GoldenExperienceR/EEE4022S_TRKJON002_Solar_Car/figures/ch4_assembled_car.jpg

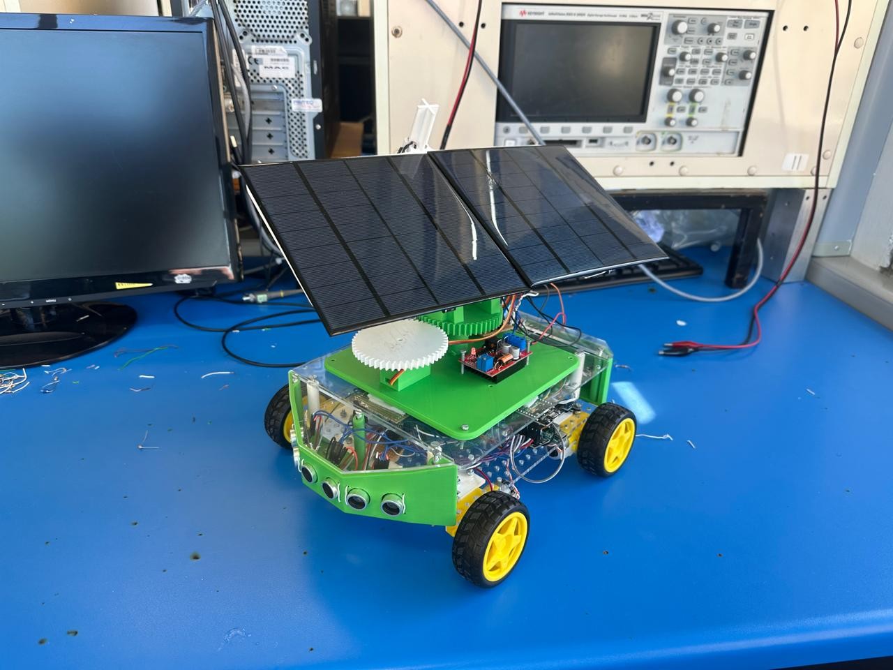
figures/ch4_assembled_car.jpg
