GoldenExperienceR/EEE4022S_TRKJON002_Solar_Car/analysis/README.md

# analysis/

Python / Jupyter post-processing of bench and track test data.

- Reduce raw captures to tidy CSV, then plot from the reduced data
- Efficiency calculations, run-time and charge-time results
- Figures exported for the report — keep the generating script alongside each figure
