GoldenExperienceR/EEE4022S_TRKJON002_Solar_Car/docs/README.md

# docs/

- Design decisions and their justification against the six project objectives
- Test procedures and results logs
- Supervisor meeting notes
- Outreach event material: pre/post interest-and-knowledge survey, media content
