GoldenExperienceR/EEE4022S_TRKJON002_Solar_Car/simulation/README.md

# simulation/

MATLAB / Simulink models and supporting scripts.

Built up submodule by submodule:
1. Solar PV under variable irradiance and temperature
2. Battery / storage
3. Motor and drivetrain
4. Power management and MPPT control
5. Full-vehicle energy model

Keep each submodule validated against literature before integrating the next.
