GoldenExperienceR/EEE4022S_TRKJON002_Solar_Car/media/out-01/out-01_questionnaire.docx

Solar Car Demonstration

Side 1: BEFORE the demonstration

University of Cape Town, Department of Electrical Engineering | Ethics approval: EBE REC EBE/03373/2026

Form ID (filled in by facilitator): ________ | Grade: ________

Section A: Consent

My parent or guardian has signed the consent form, and I agree to take part. ☐ Yes ☐ No

If you ticked No, please stop here and hand this sheet back. You can still watch and enjoy the demonstration.

Do not write your name anywhere. Your answers are anonymous, there are no right or wrong answers, and this is not a test.

For each statement, tick ONE box: 1 = Not at all 2 = A little 3 = Somewhat 4 = Quite a lot 5 = Very much

Section B: Your understanding right now

# | Statement | 1 | 2 | 3 | 4 | 5

B1 | I understand what engineers do. | ☐ | ☐ | ☐ | ☐ | ☐
B2 | I understand how electrical engineering is used in everyday devices. | ☐ | ☐ | ☐ | ☐ | ☐
B3 | I understand how solar (renewable) energy can be used to power something, like a small vehicle. | ☐ | ☐ | ☐ | ☐ | ☐
B4 | I understand how different types of engineering (e.g. mechanical, electrical, renewable energy, coding) work together on a single project. | ☐ | ☐ | ☐ | ☐ | ☐

Section C: Your interest right now

# | Statement | 1 | 2 | 3 | 4 | 5

C1 | I am interested in learning more about engineering. | ☐ | ☐ | ☐ | ☐ | ☐
C2 | I would consider studying engineering in the future. | ☐ | ☐ | ☐ | ☐ | ☐
C3 | I am interested in careers related to science, technology, engineering or maths (STEM). | ☐ | ☐ | ☐ | ☐ | ☐
C4 | I am interested in working in renewable energy one day. | ☐ | ☐ | ☐ | ☐ | ☐

Do not turn over yet. Keep this sheet; you will fill in Side 2 after the demonstration.

Solar Car Demonstration

Side 2: AFTER the demonstration

Only fill in this side when the facilitator asks you to, after the demonstration. Same sheet and same Form ID as Side 1.

For each statement, tick ONE box: 1 = Not at all 2 = A little 3 = Somewhat 4 = Quite a lot 5 = Very much

Section B: Your understanding now, after the demonstration

# | Statement | 1 | 2 | 3 | 4 | 5

B1 | I understand what engineers do. | ☐ | ☐ | ☐ | ☐ | ☐
B2 | I understand how electrical engineering is used in everyday devices. | ☐ | ☐ | ☐ | ☐ | ☐
B3 | I understand how solar (renewable) energy can be used to power something, like a small vehicle. | ☐ | ☐ | ☐ | ☐ | ☐
B4 | I understand how different types of engineering (e.g. mechanical, electrical, renewable energy, coding) work together on a single project. | ☐ | ☐ | ☐ | ☐ | ☐

Section C: Your interest now, after the demonstration

# | Statement | 1 | 2 | 3 | 4 | 5

C1 | I am interested in learning more about engineering. | ☐ | ☐ | ☐ | ☐ | ☐
C2 | I would consider studying engineering in the future. | ☐ | ☐ | ☐ | ☐ | ☐
C3 | I am interested in careers related to science, technology, engineering or maths (STEM). | ☐ | ☐ | ☐ | ☐ | ☐
C4 | I am interested in working in renewable energy one day. | ☐ | ☐ | ☐ | ☐ | ☐

Section D: Your impression of today's demonstration

# | Statement | 1 | 2 | 3 | 4 | 5

D1 | I enjoyed today's demonstration. | ☐ | ☐ | ☐ | ☐ | ☐
D2 | The demonstration was easy to understand. | ☐ | ☐ | ☐ | ☐ | ☐
D3 | Today's demonstration made me more curious about engineering. | ☐ | ☐ | ☐ | ☐ | ☐
D4 | Did you drive the car yourself? If No, skip D5 to D7. | ☐ Yes ☐ No
D5 | The phone dashboard was easy to use. | ☐ | ☐ | ☐ | ☐ | ☐
D6 | I liked the look of the dashboard. | ☐ | ☐ | ☐ | ☐ | ☐
D7 | Driving was easier with co-pilot on than with it off. | ☐ | ☐ | ☐ | ☐ | ☐
D8 | Seeing live data (solar power, battery, speed) helped me understand how the car works. | ☐ | ☐ | ☐ | ☐ | ☐
D9 | Being able to drive the car made the demonstration more interesting. | ☐ | ☐ | ☐ | ☐ | ☐

Thank you! Please hand this sheet back to the facilitator.
