GoldenExperienceR/EEE4022S_TRKJON002_Solar_Car/figures/app_consent_form-2.png

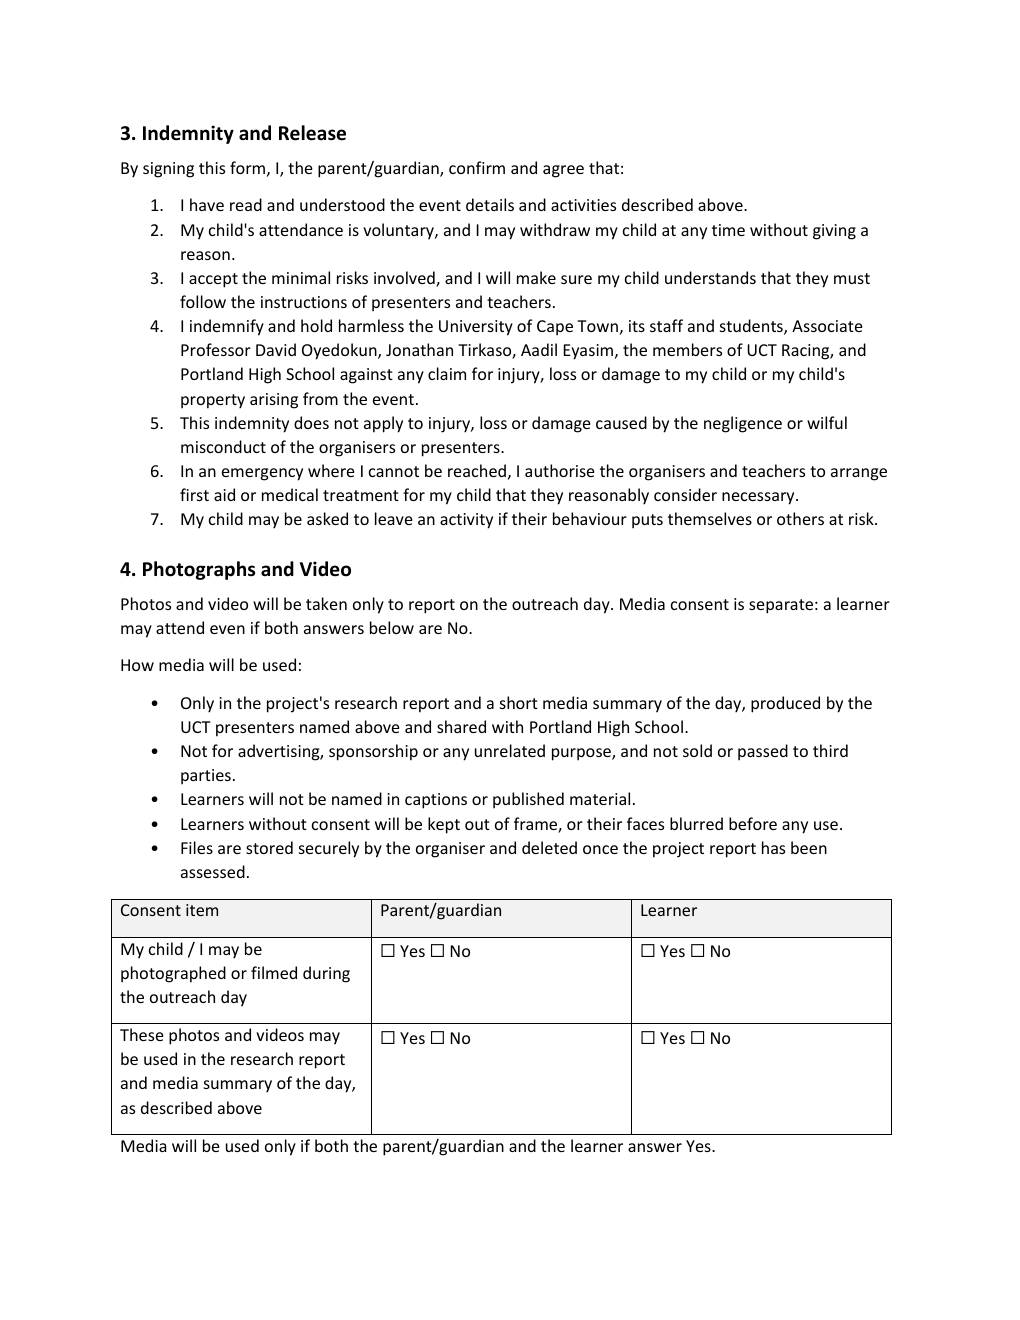
figures/app_consent_form-2.png
