GoldenExperienceR/EEE4022S_TRKJON002_Solar_Car/figures/app_ethics_approval-1.png

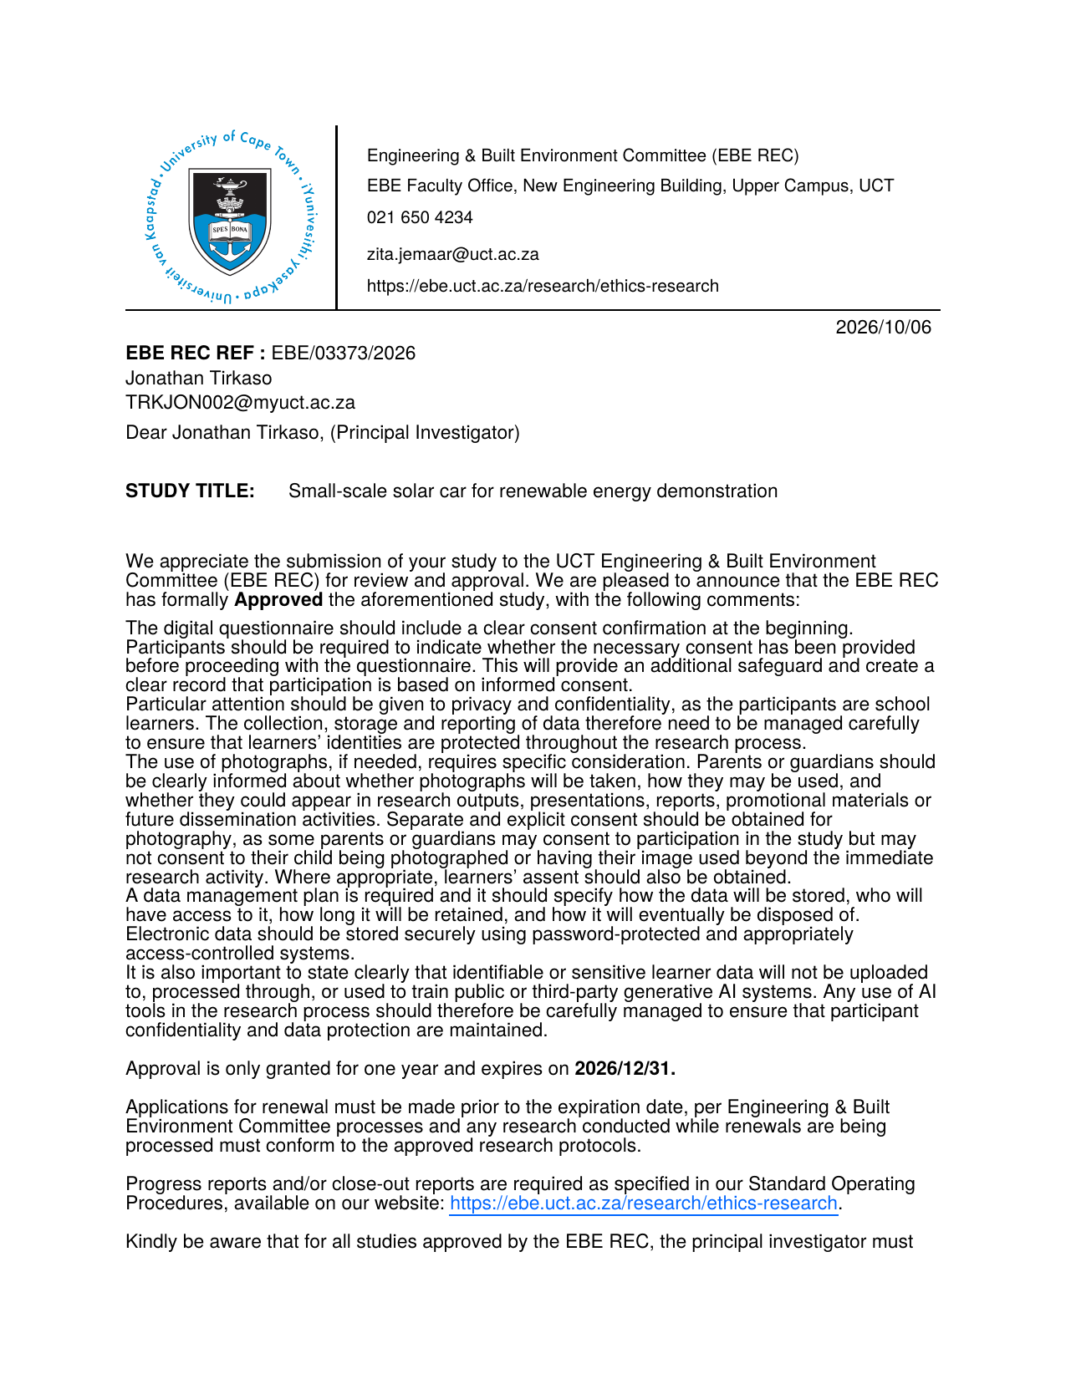
figures/app_ethics_approval-1.png
