GoldenExperienceR/EEE4022S_TRKJON002_Solar_Car/figures/app_photo_front.jpg

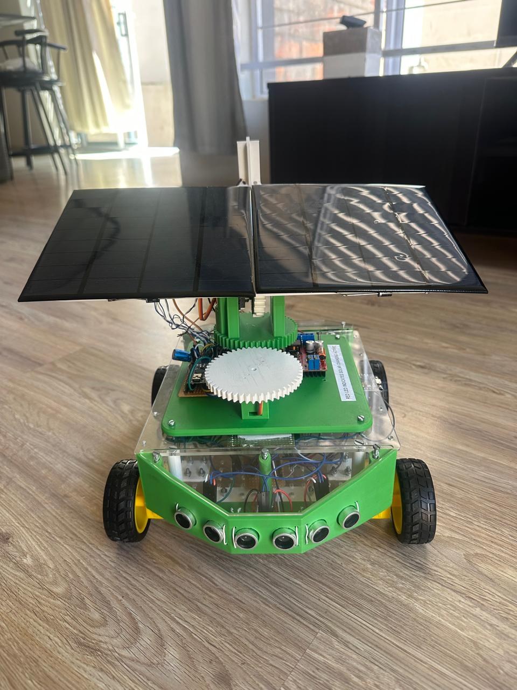
figures/app_photo_front.jpg
