GoldenExperienceR/EEE4022S_TRKJON002_Solar_Car/figures/app_photo_rear.jpg

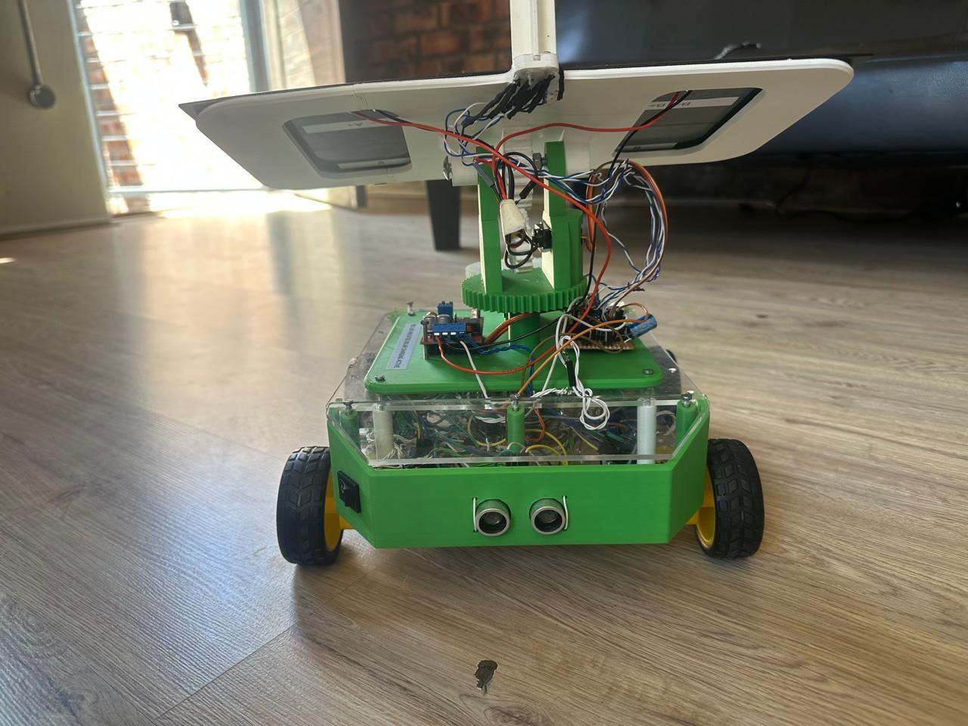
figures/app_photo_rear.jpg
