GoldenExperienceR/EEE4022S_TRKJON002_Solar_Car/figures/app_vehicle_front.jpg

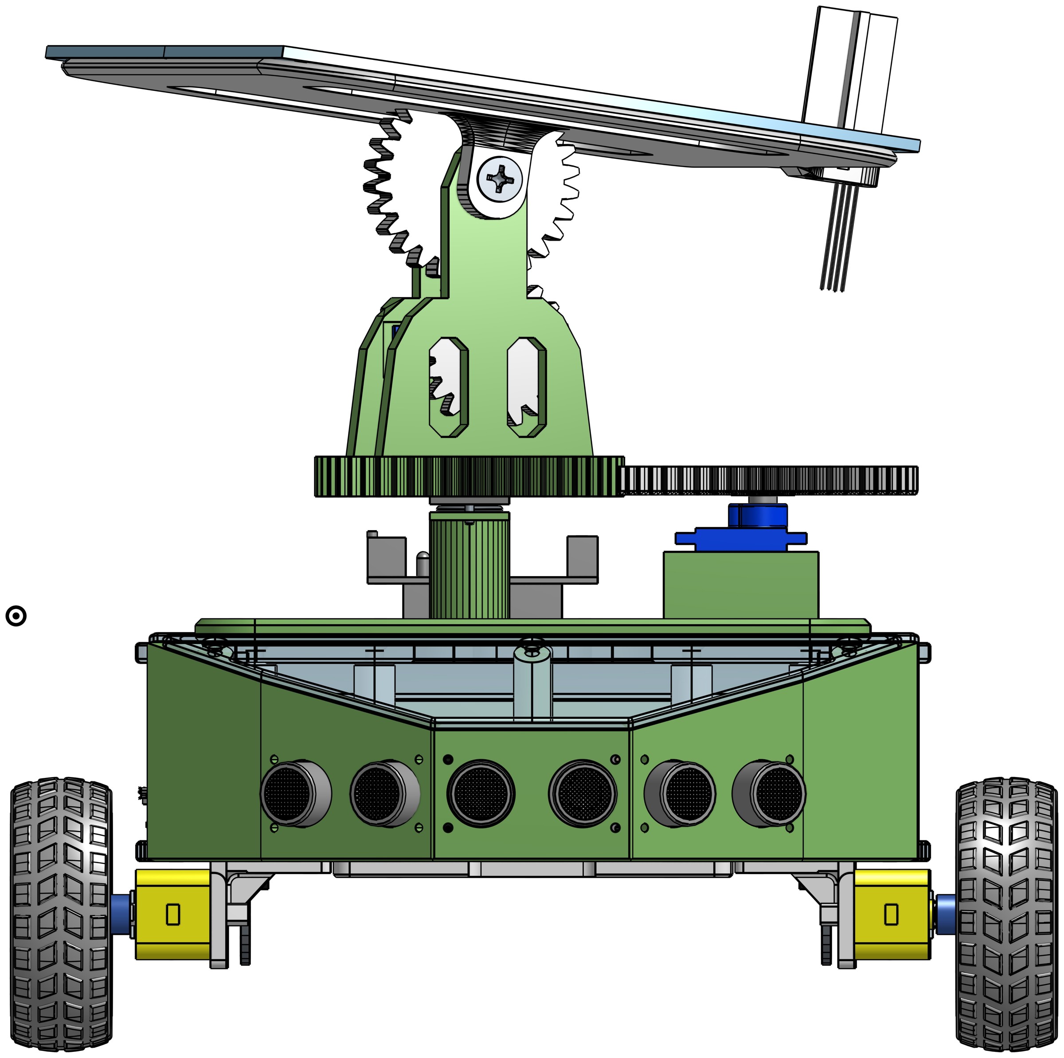
figures/app_vehicle_front.jpg
