GoldenExperienceR/EEE4022S_TRKJON002_Solar_Car/figures/app_vehicle_rear.jpg

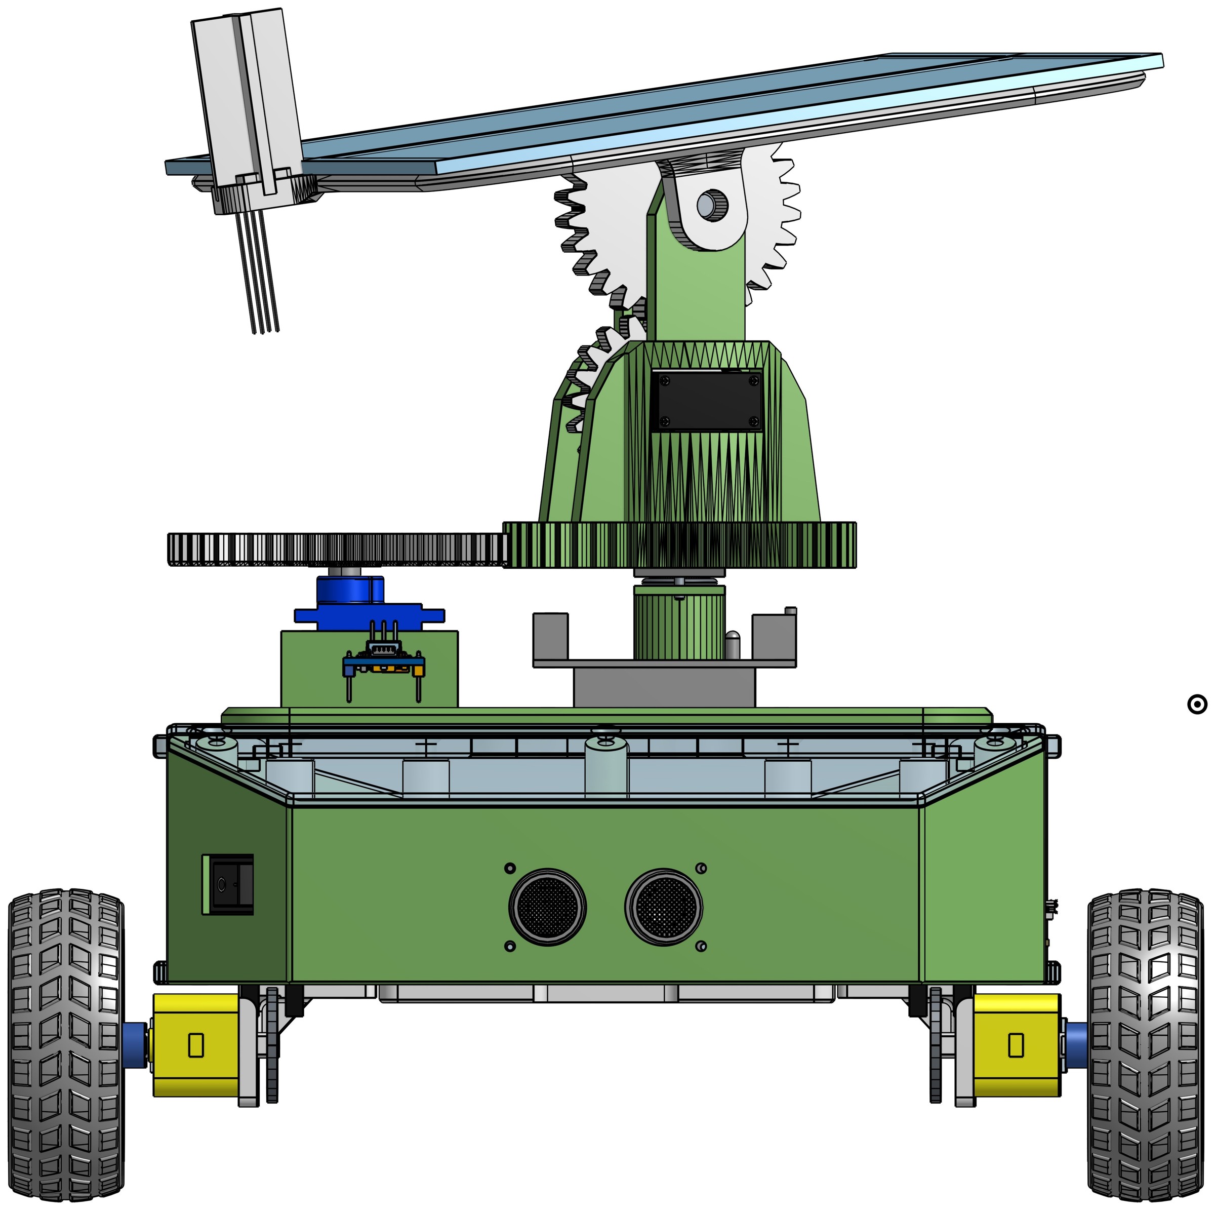
figures/app_vehicle_rear.jpg
