GoldenExperienceR/EEE4022S_TRKJON002_Solar_Car/figures/ch2_array_config_bottom.png

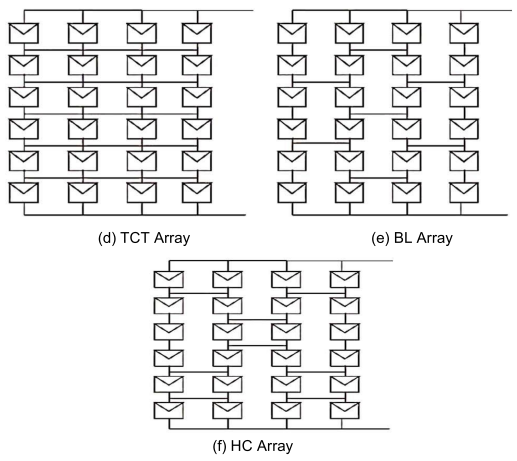
figures/ch2_array_config_bottom.png
