GoldenExperienceR/EEE4022S_TRKJON002_Solar_Car/figures/ch2_array_config_top.png

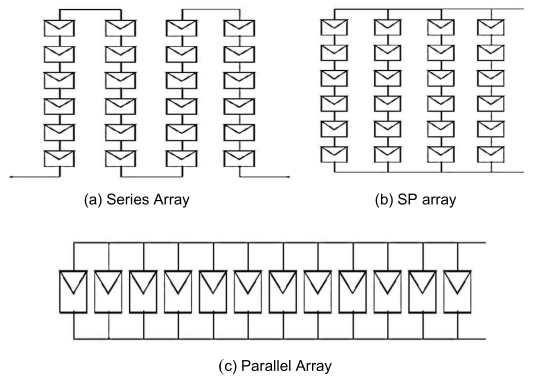
figures/ch2_array_config_top.png
