GoldenExperienceR/EEE4022S_TRKJON002_Solar_Car/figures/ch2_effect_irradiance.png

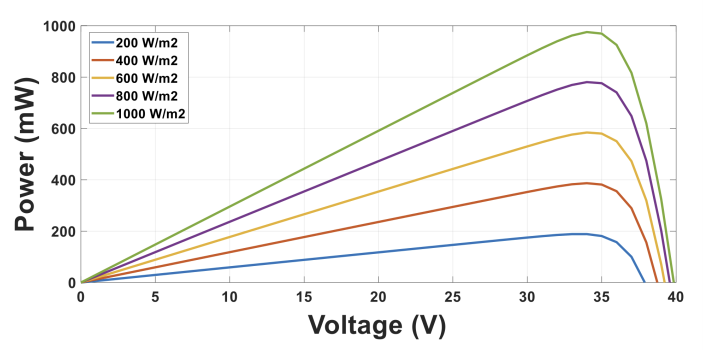
figures/ch2_effect_irradiance.png
