GoldenExperienceR/EEE4022S_TRKJON002_Solar_Car/figures/ch2_effect_series_r.png

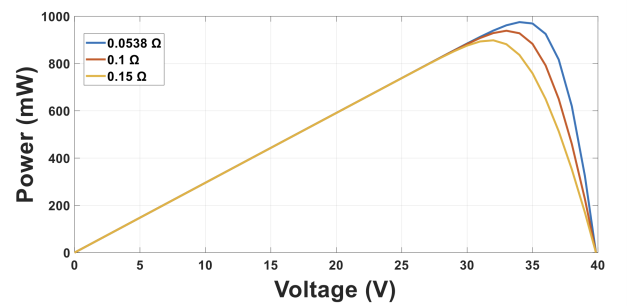
figures/ch2_effect_series_r.png
