GoldenExperienceR/EEE4022S_TRKJON002_Solar_Car/figures/ch2_effect_temperature.png

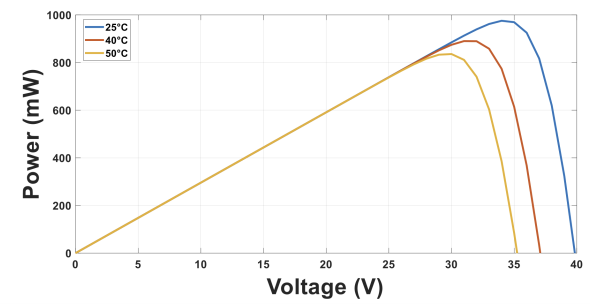
figures/ch2_effect_temperature.png
