GoldenExperienceR/EEE4022S_TRKJON002_Solar_Car/figures/ch2_howell2023_tail.png

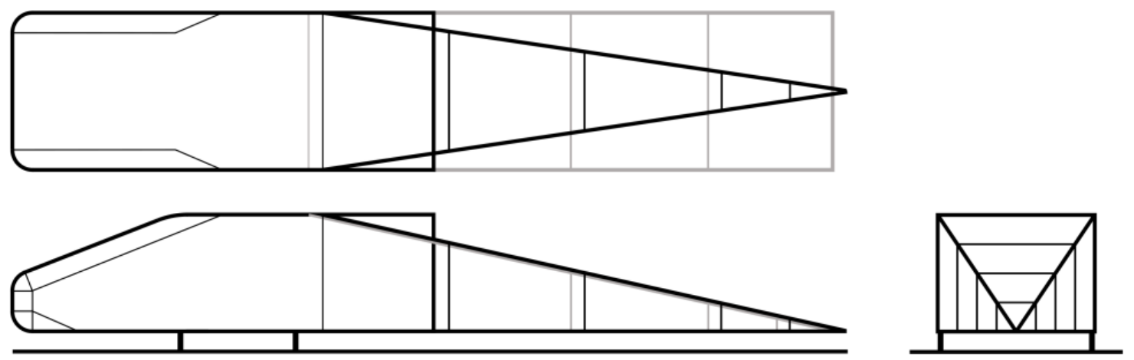
figures/ch2_howell2023_tail.png
