GoldenExperienceR/EEE4022S_TRKJON002_Solar_Car/figures/ch2_iv_pv_curves.png

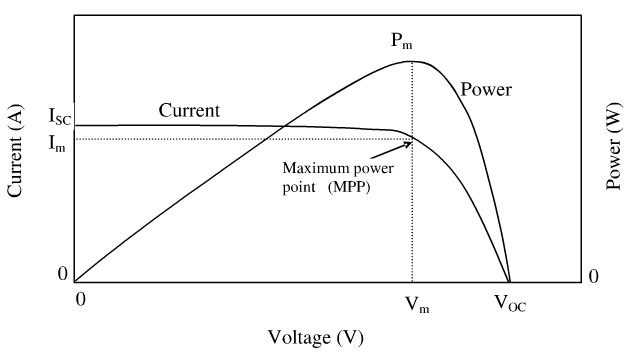
figures/ch2_iv_pv_curves.png
