GoldenExperienceR/EEE4022S_TRKJON002_Solar_Car/figures/ch2_microev_control.png

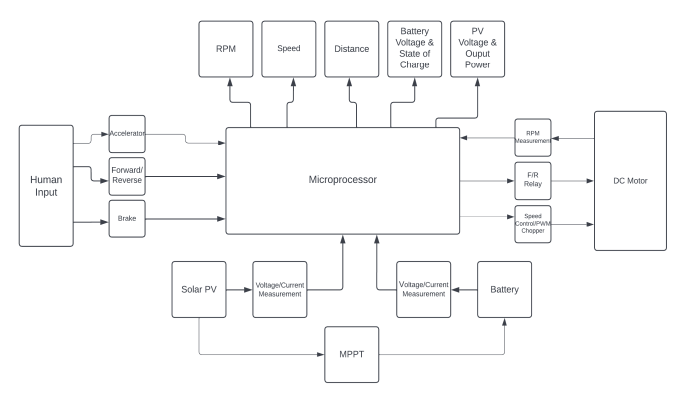
figures/ch2_microev_control.png
