GoldenExperienceR/EEE4022S_TRKJON002_Solar_Car/figures/ch2_microev_power_stage.png

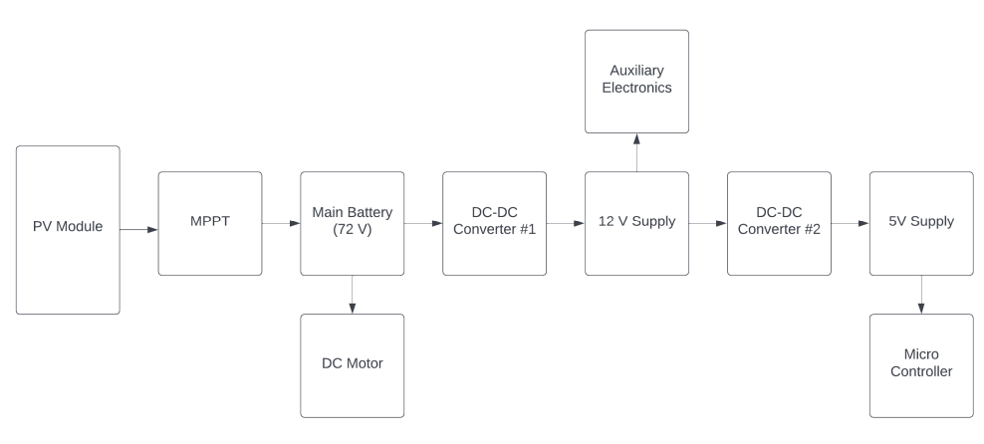
figures/ch2_microev_power_stage.png
