GoldenExperienceR/EEE4022S_TRKJON002_Solar_Car/figures/ch2_mppt_simulink.png

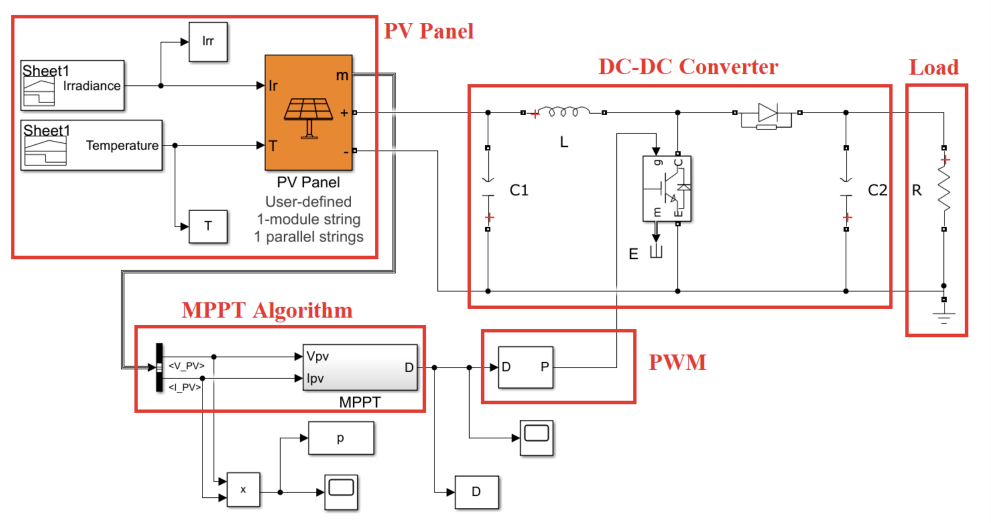
figures/ch2_mppt_simulink.png
