GoldenExperienceR/EEE4022S_TRKJON002_Solar_Car/figures/ch2_ocv_soc_lfp.png

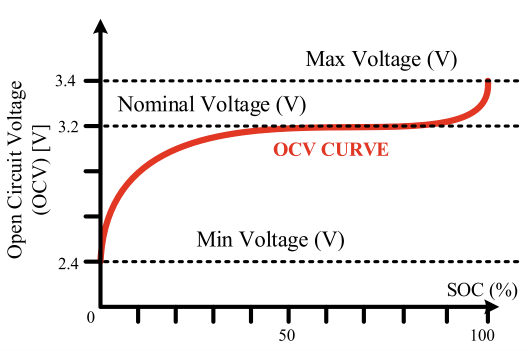
figures/ch2_ocv_soc_lfp.png
