GoldenExperienceR/EEE4022S_TRKJON002_Solar_Car/figures/ch2_pv_cell_junction.png

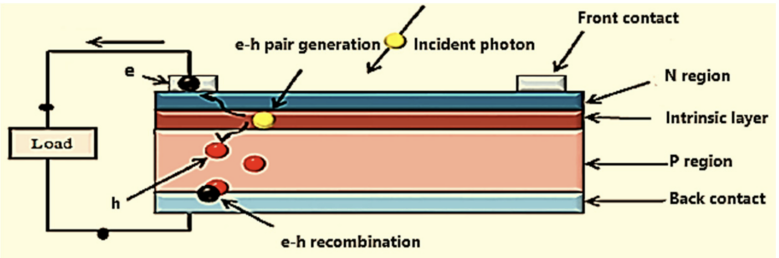
figures/ch2_pv_cell_junction.png
