GoldenExperienceR/EEE4022S_TRKJON002_Solar_Car/figures/ch2_schito2024_nose.png

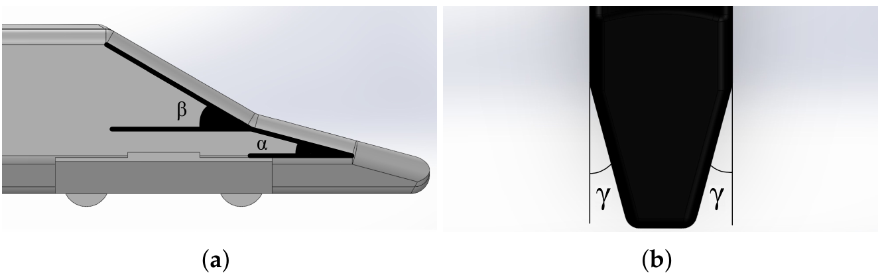
figures/ch2_schito2024_nose.png
