GoldenExperienceR/EEE4022S_TRKJON002_Solar_Car/figures/ch2_shading_distortion.png

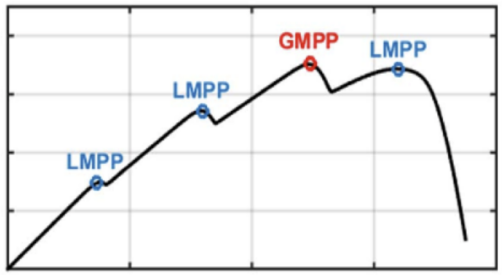
figures/ch2_shading_distortion.png
