GoldenExperienceR/EEE4022S_TRKJON002_Solar_Car/figures/ch2_single_diode_model.png

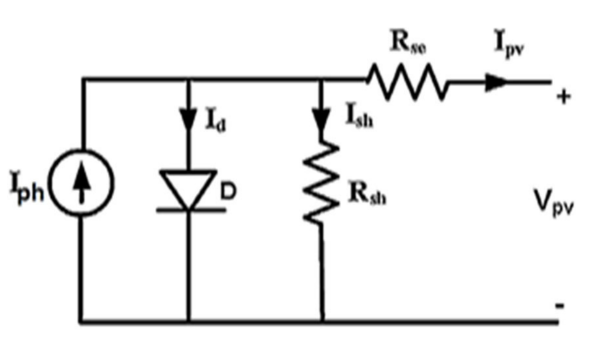
figures/ch2_single_diode_model.png
