GoldenExperienceR/EEE4022S_TRKJON002_Solar_Car/figures/ch2_v3_block_diagram.png

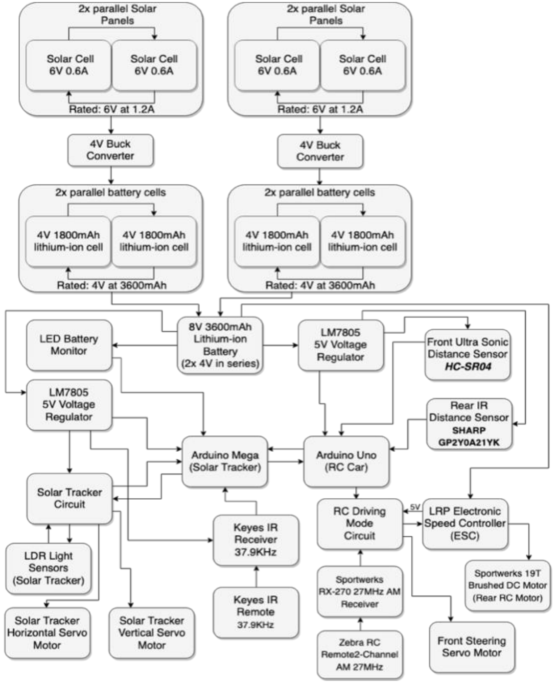
figures/ch2_v3_block_diagram.png
