GoldenExperienceR/EEE4022S_TRKJON002_Solar_Car/figures/ch2_v3_tracker_isometric.png

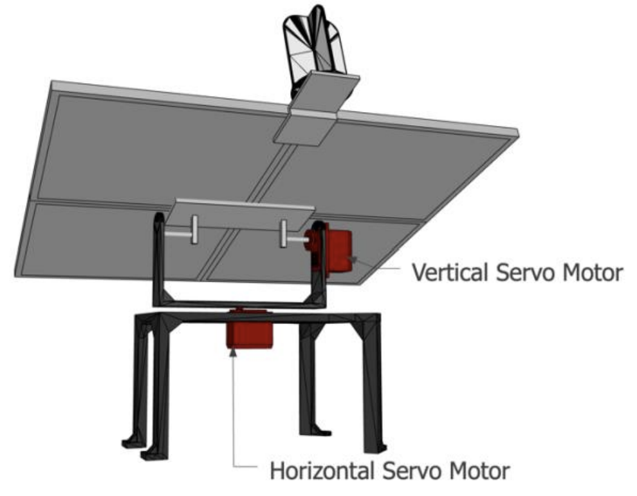
figures/ch2_v3_tracker_isometric.png
