GoldenExperienceR/EEE4022S_TRKJON002_Solar_Car/figures/ch3_copilot_controller.png

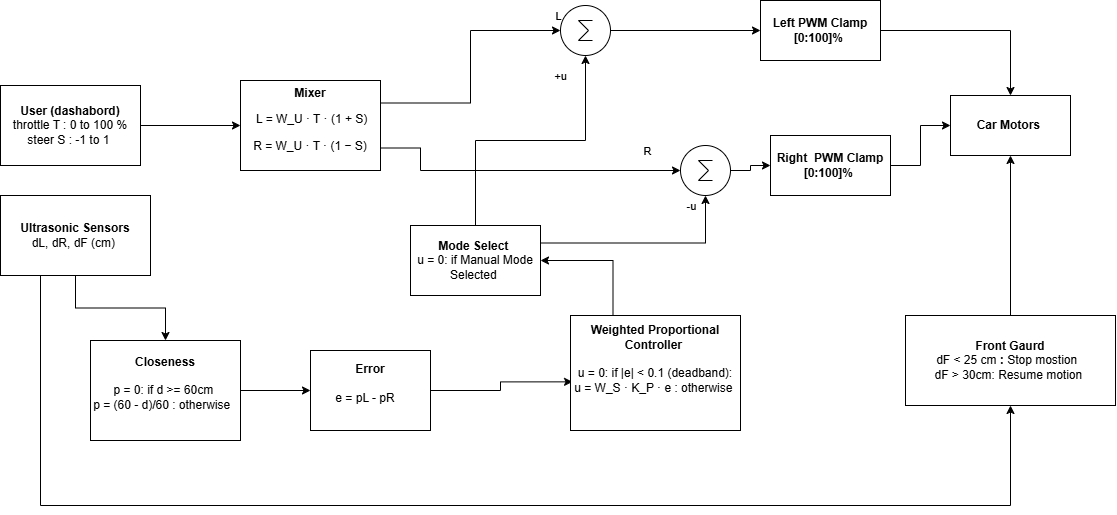
figures/ch3_copilot_controller.png
