GoldenExperienceR/EEE4022S_TRKJON002_Solar_Car/figures/ch3_sim_battery_load.png

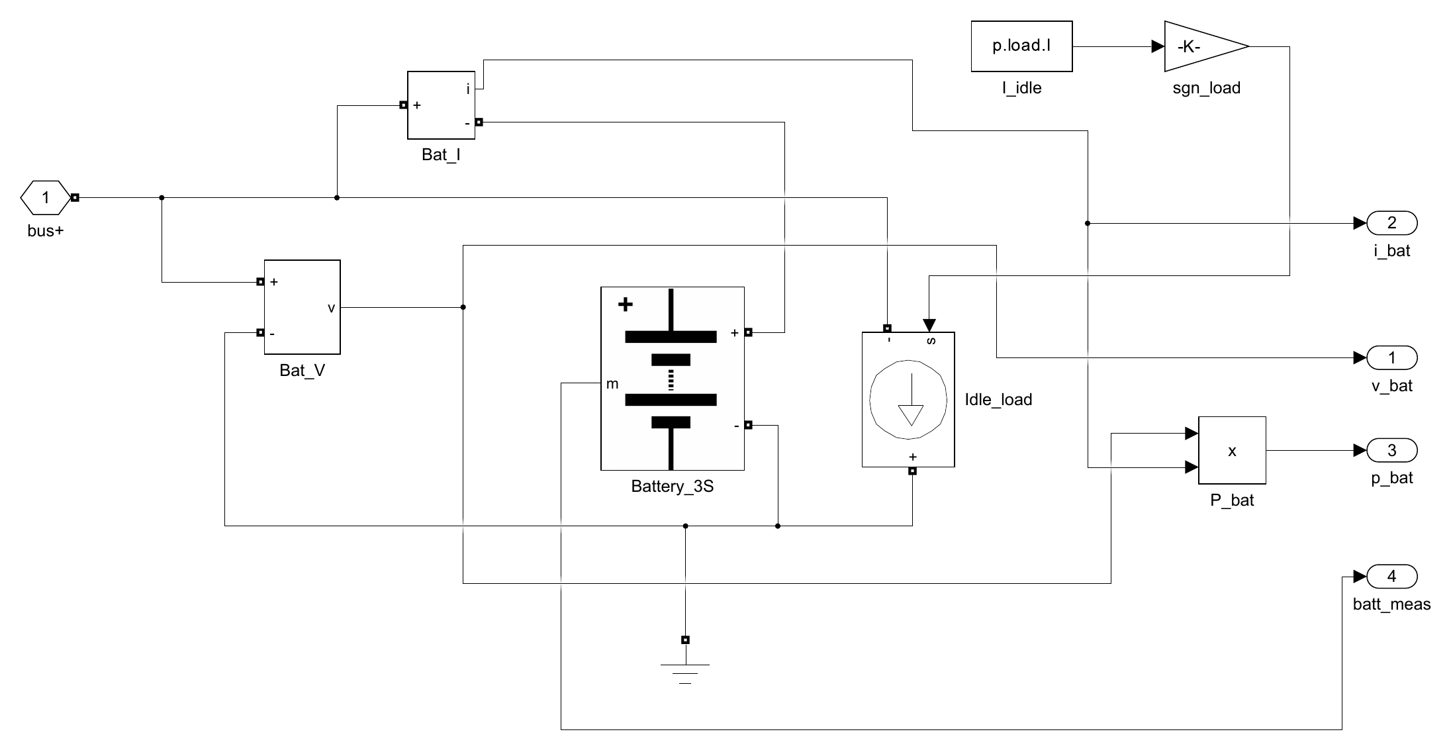
figures/ch3_sim_battery_load.png
