GoldenExperienceR/EEE4022S_TRKJON002_Solar_Car/figures/ch3_sim_converter.png

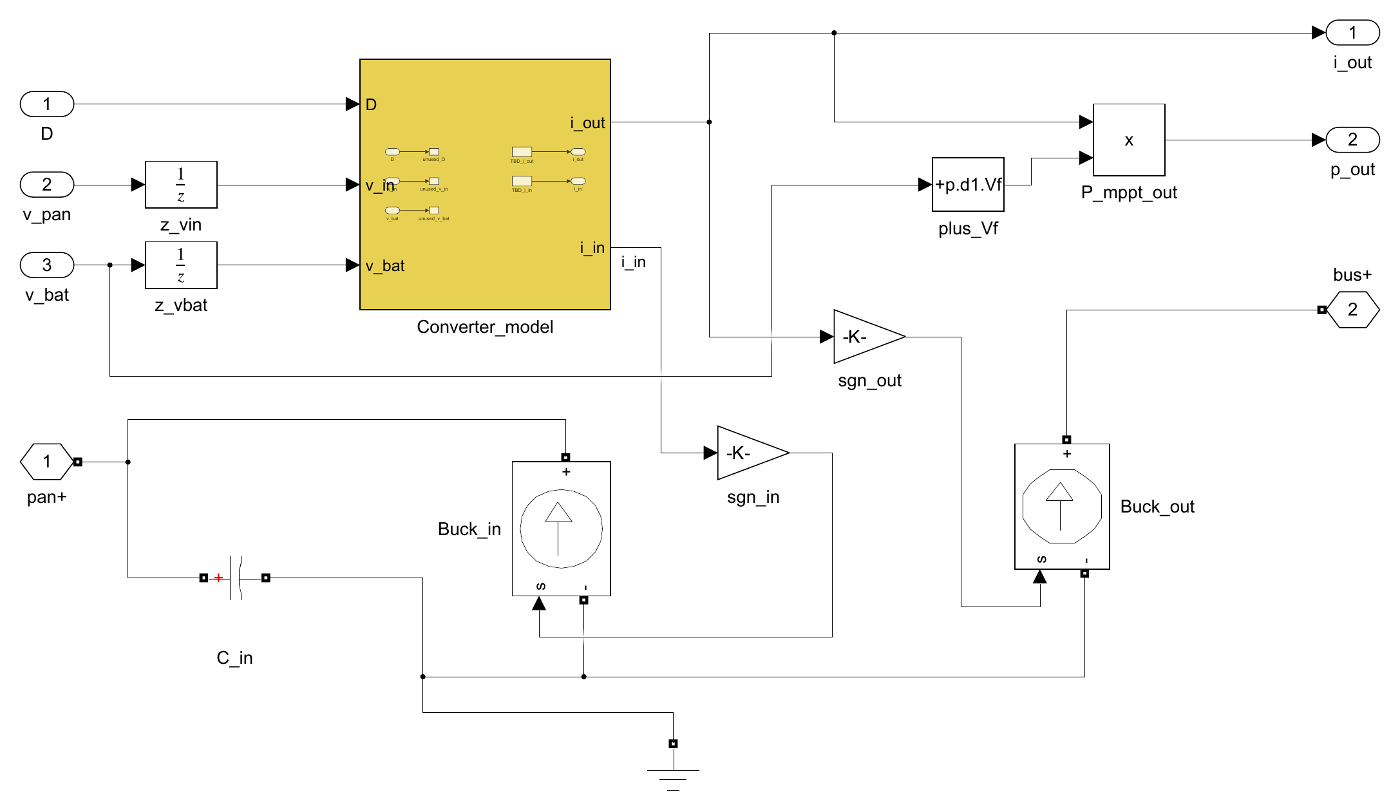
figures/ch3_sim_converter.png
