GoldenExperienceR/EEE4022S_TRKJON002_Solar_Car/figures/ch3_sim_logging.png

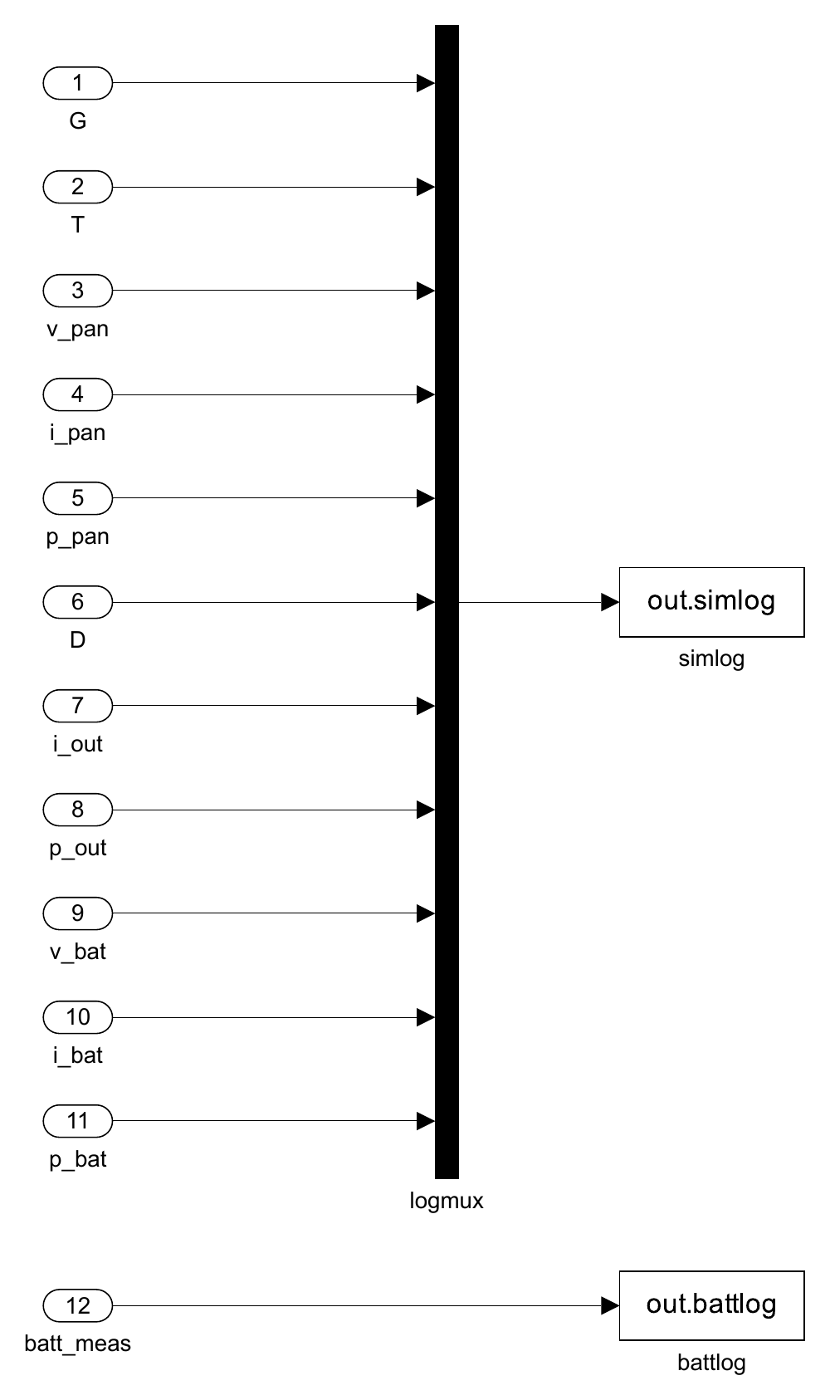
figures/ch3_sim_logging.png
