GoldenExperienceR/EEE4022S_TRKJON002_Solar_Car/figures/ch3_sim_pv_array.png

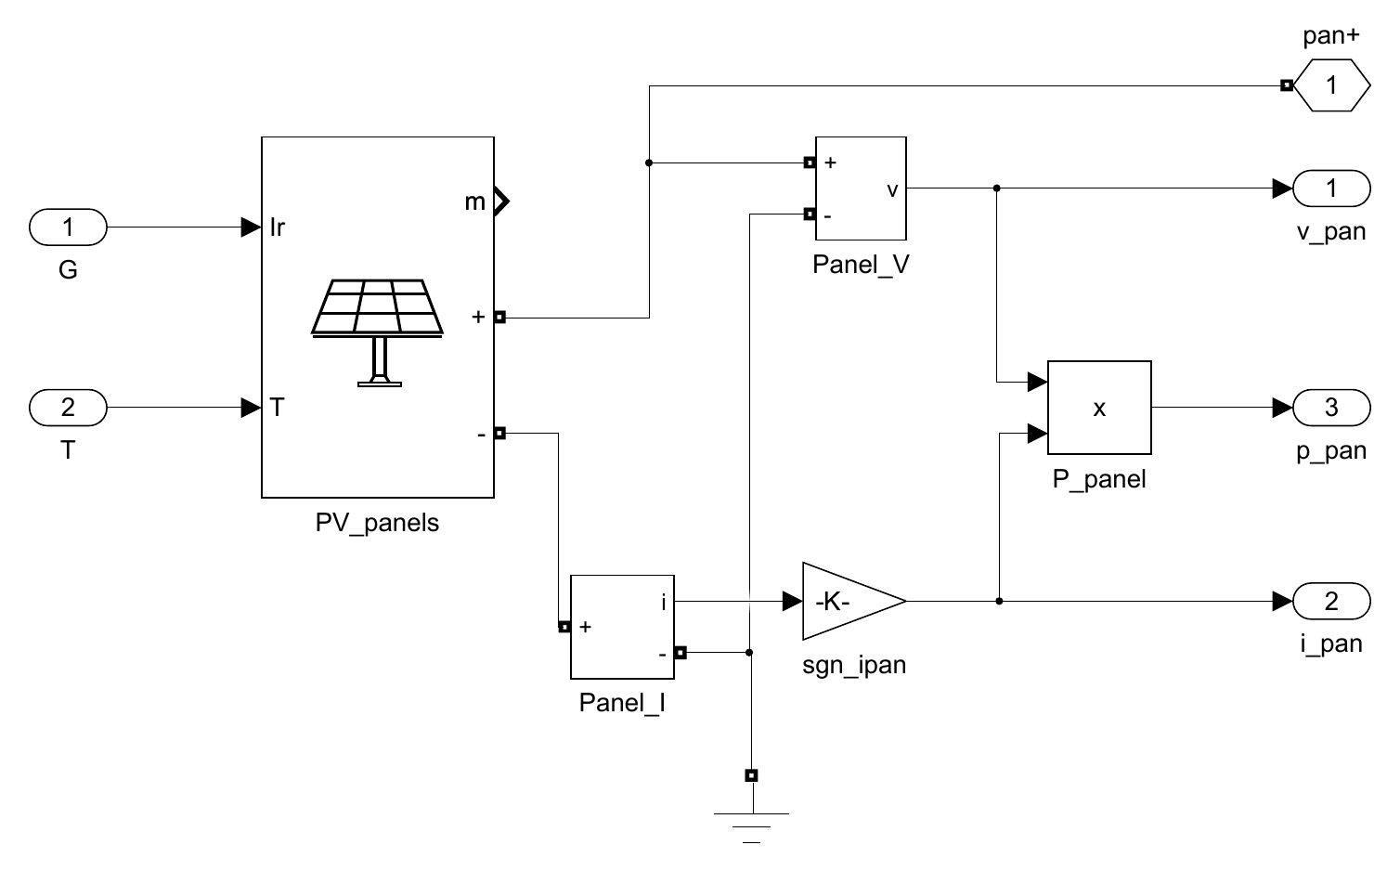
figures/ch3_sim_pv_array.png
