GoldenExperienceR/EEE4022S_TRKJON002_Solar_Car/figures/ch3_system_architecture.png

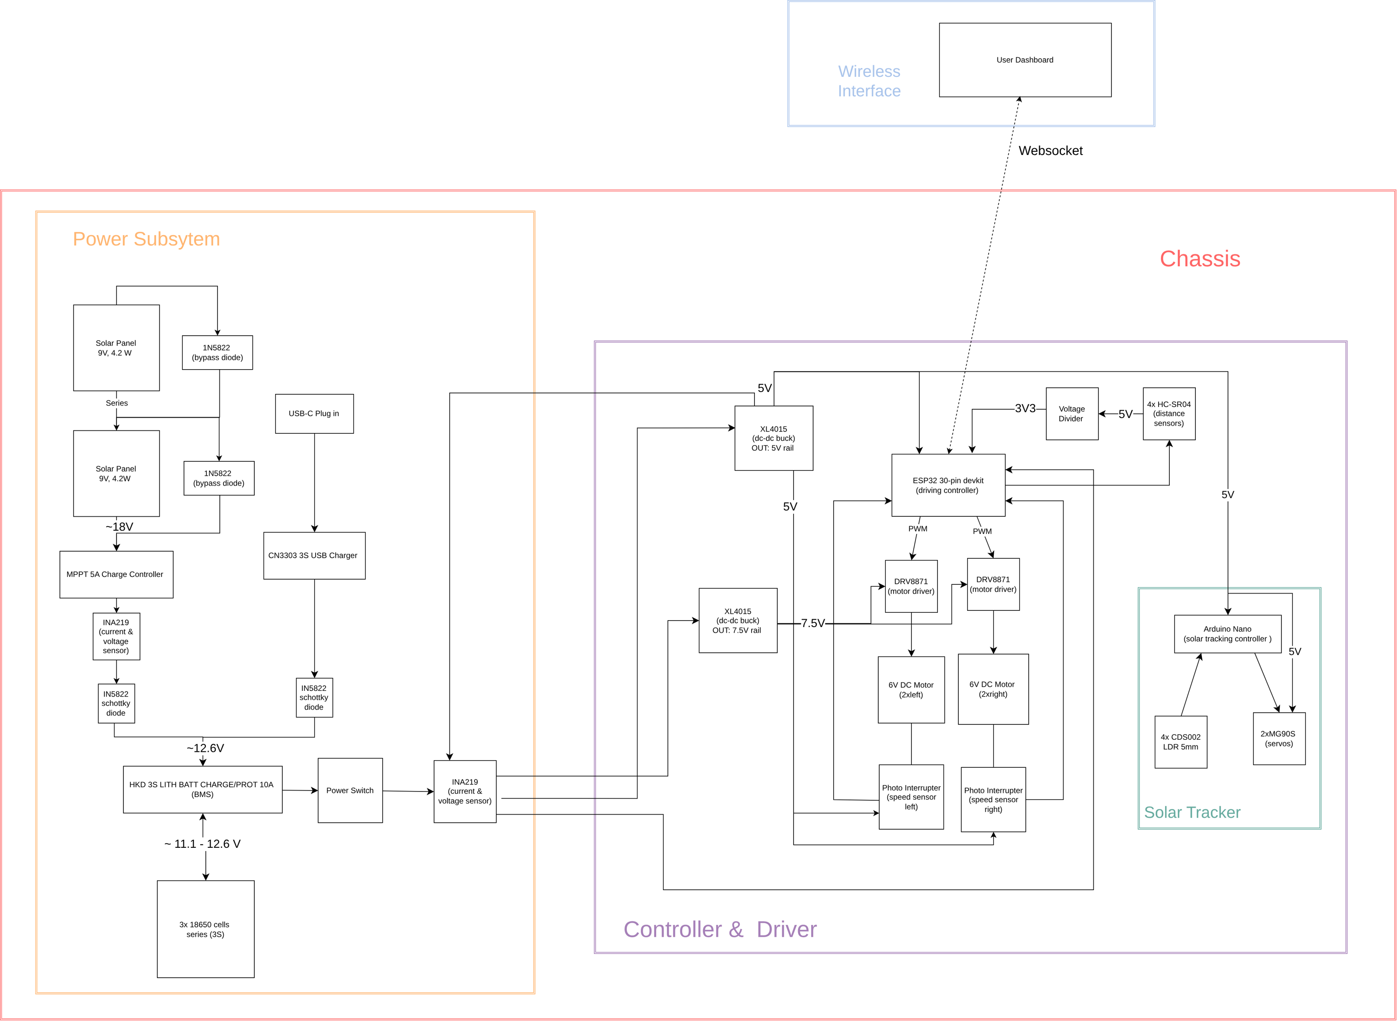
figures/ch3_system_architecture.png
