GoldenExperienceR/EEE4022S_TRKJON002_Solar_Car/figures/int02_drive_distance.jpg

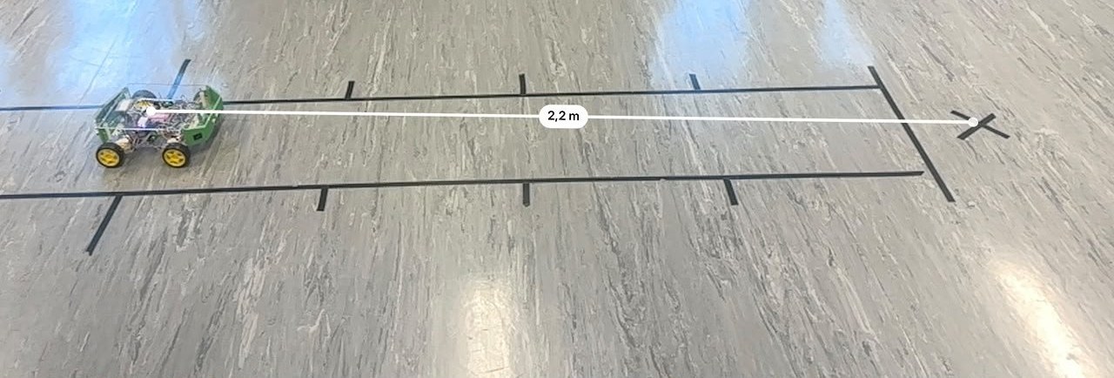
figures/int02_drive_distance.jpg
