GoldenExperienceR/EEE4022S_TRKJON002_Solar_Car/figures/out01_impressions_all.png

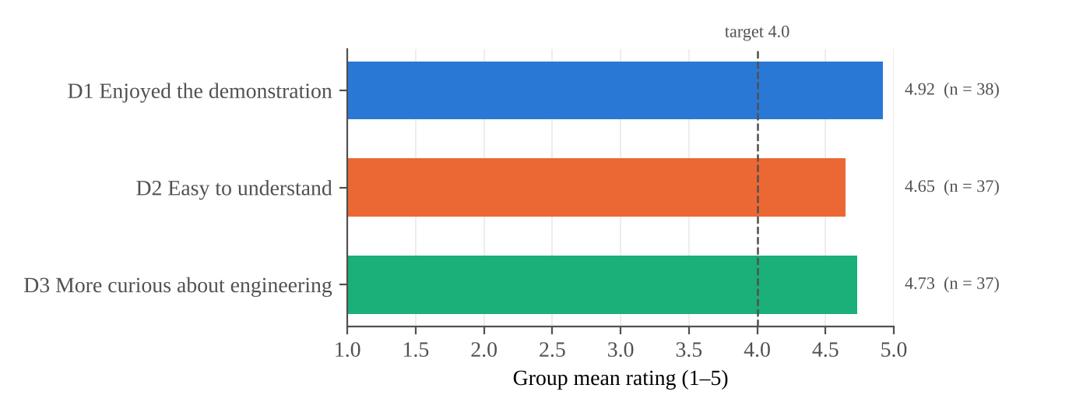
figures/out01_impressions_all.png
