GoldenExperienceR/EEE4022S_TRKJON002_Solar_Car/figures/out01_pre_post_means.png

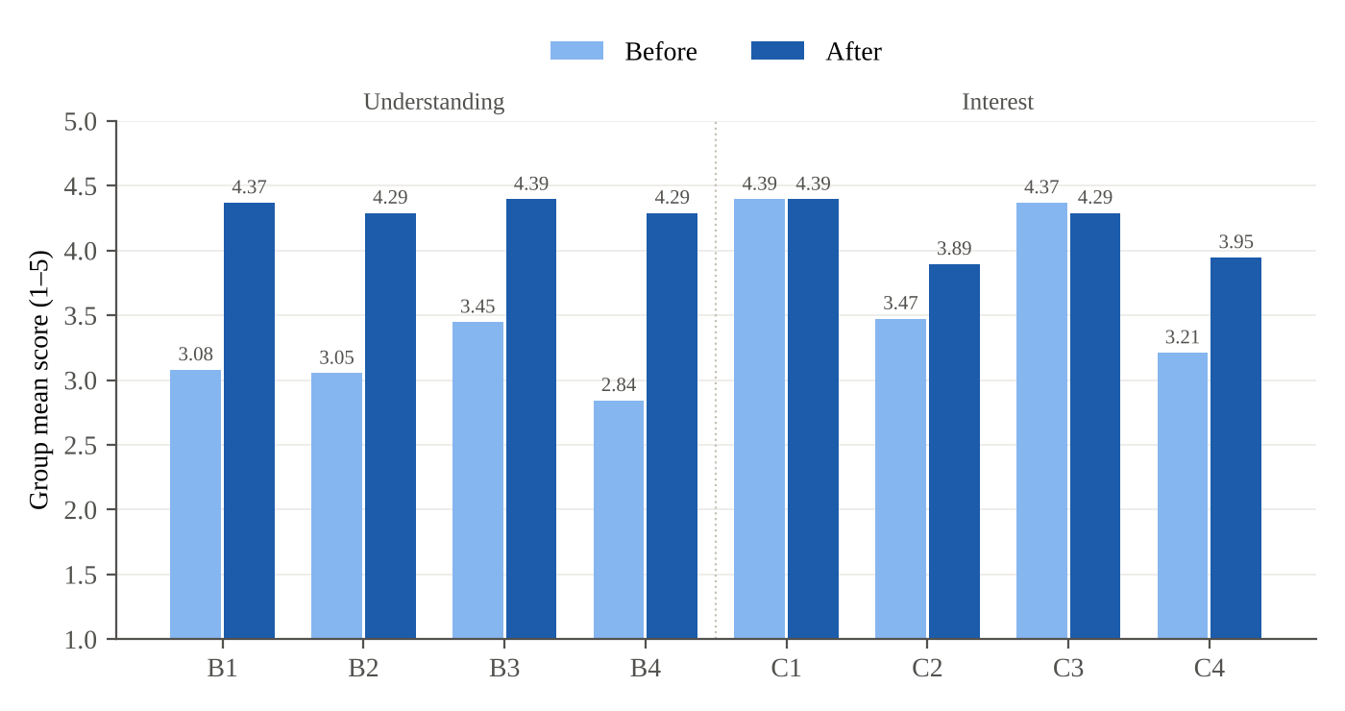
figures/out01_pre_post_means.png
