GoldenExperienceR/EEE4022S_TRKJON002_Solar_Car/figures/sim01_charging.png

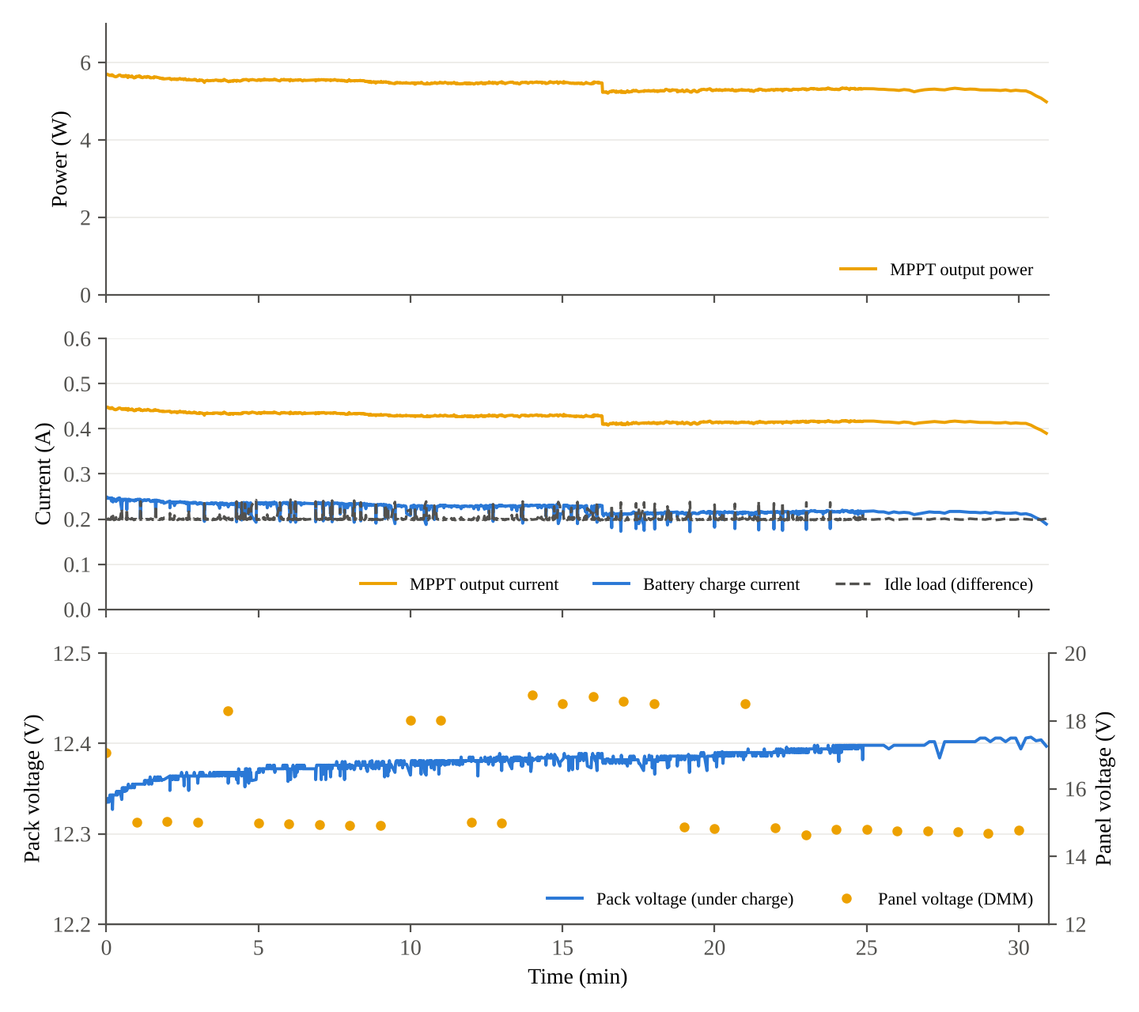
figures/sim01_charging.png
