GoldenExperienceR/EEE4022S_TRKJON002_Solar_Car/figures/sim01_conditions.png

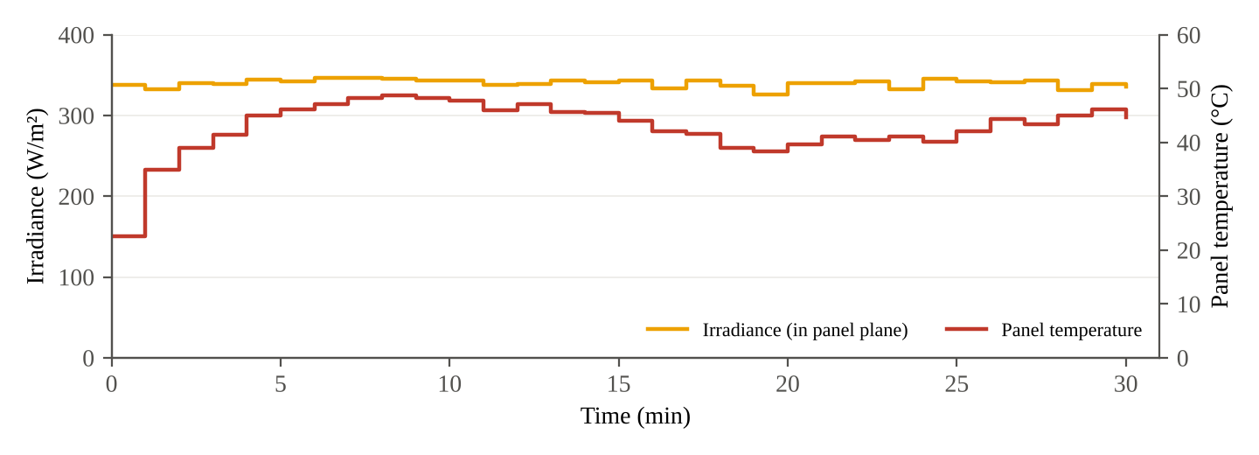
figures/sim01_conditions.png
