GoldenExperienceR/EEE4022S_TRKJON002_Solar_Car/figures/sys10_mass.jpg

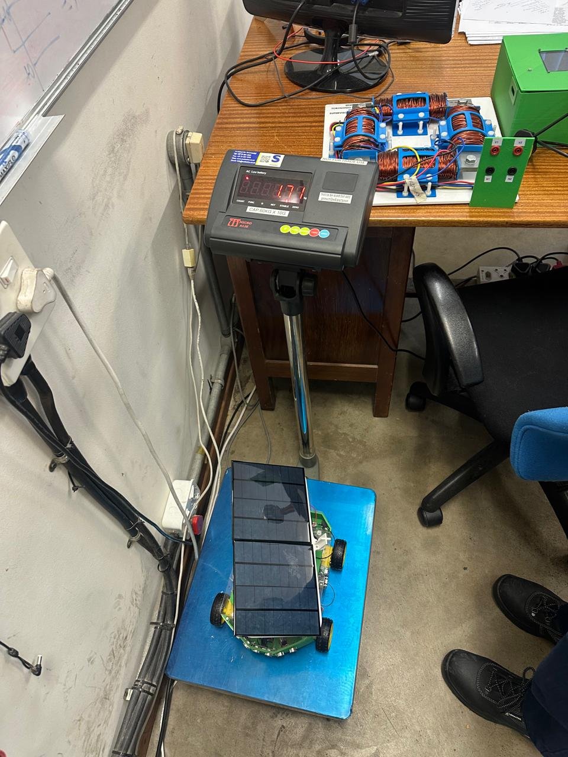
figures/sys10_mass.jpg
