GoldenExperienceR/EEE4022S_TRKJON002_Solar_Car/figures/sys14_shade1.png

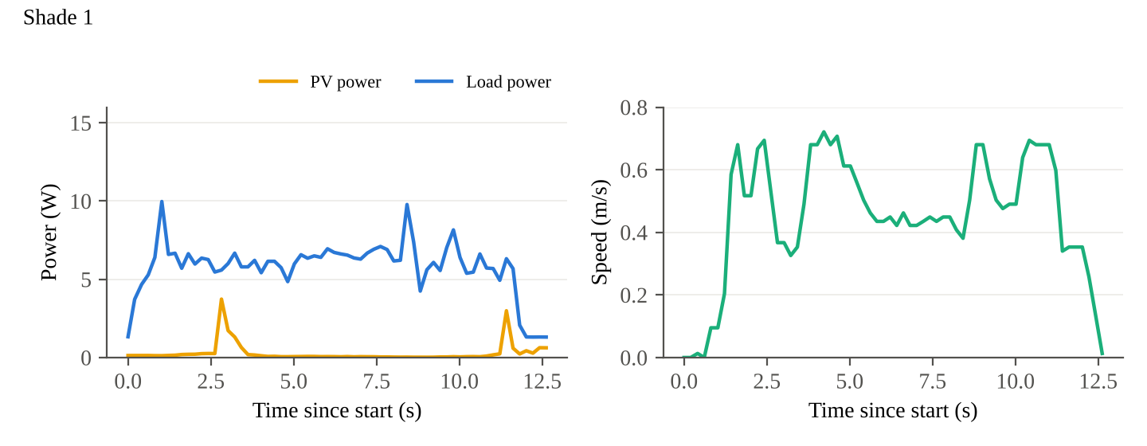
figures/sys14_shade1.png
