GoldenExperienceR/EEE4022S_TRKJON002_Solar_Car/figures/sys14_sun1.png

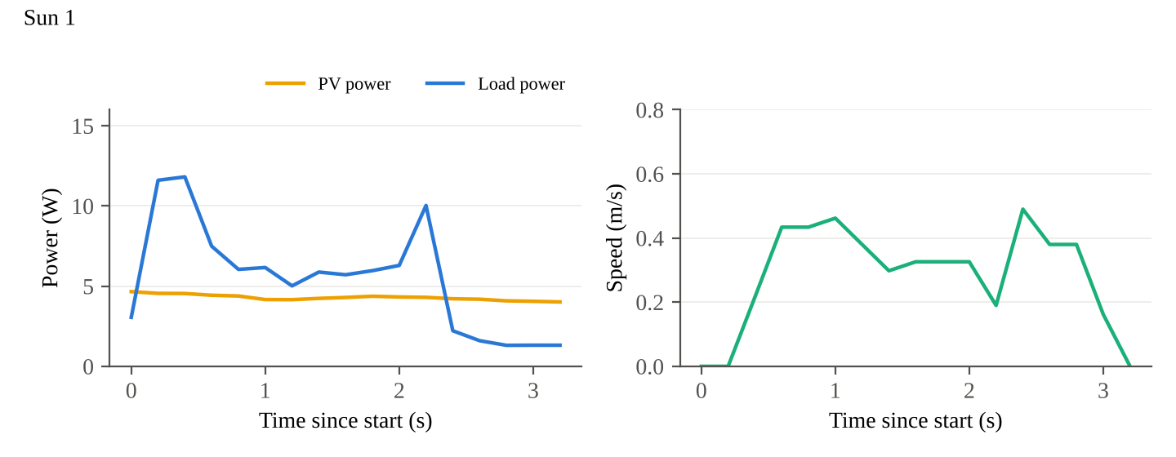
figures/sys14_sun1.png
