GoldenExperienceR/EEE4022S_TRKJON002_Solar_Car/figures/u04_ripple_buck_a.png

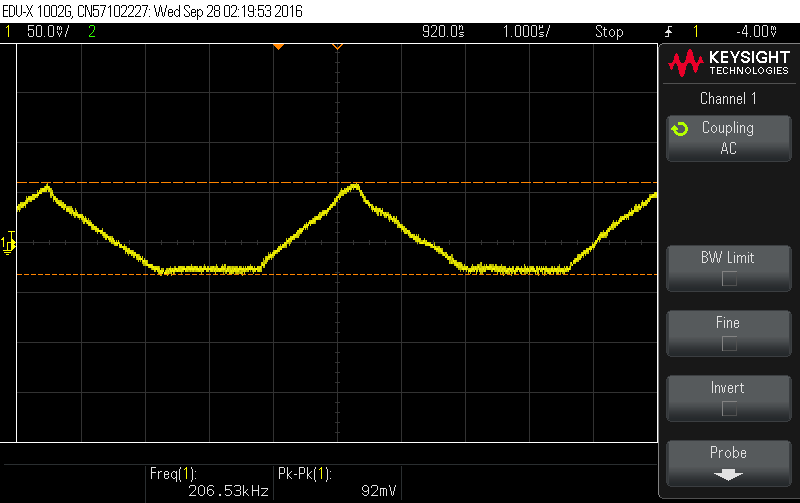
figures/u04_ripple_buck_a.png
