GoldenExperienceR/EEE4022S_TRKJON002_Solar_Car/figures/u07_mppt_charge_ripple.png

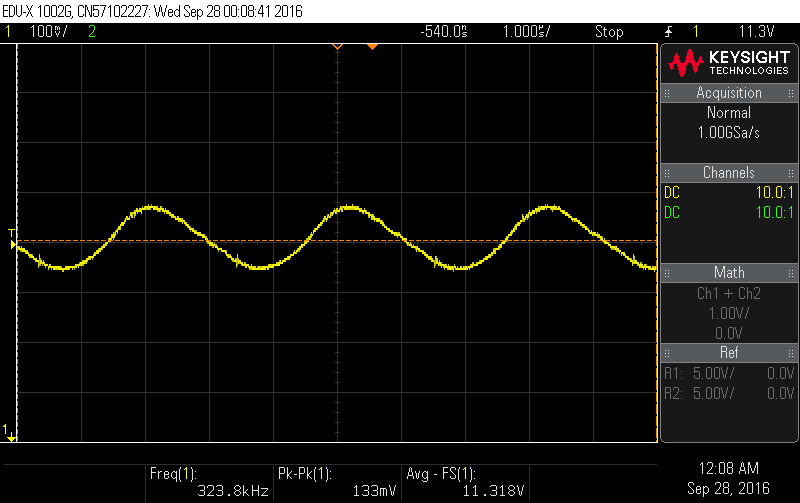
figures/u07_mppt_charge_ripple.png
