GoldenExperienceR/EEE4022S_TRKJON002_Solar_Car/figures/u07_mppt_output_bench.png

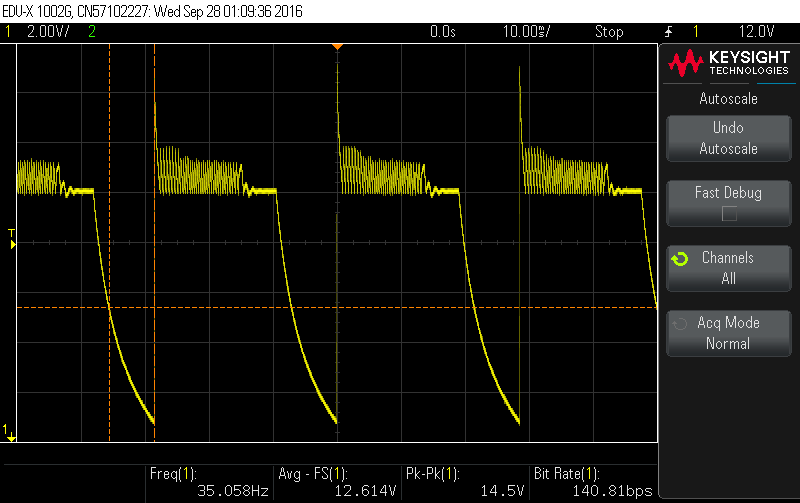
figures/u07_mppt_output_bench.png
