GoldenExperienceR/EEE4022S_TRKJON002_Solar_Car/media/sys-06/sys-06_dashboard_before-usb.png

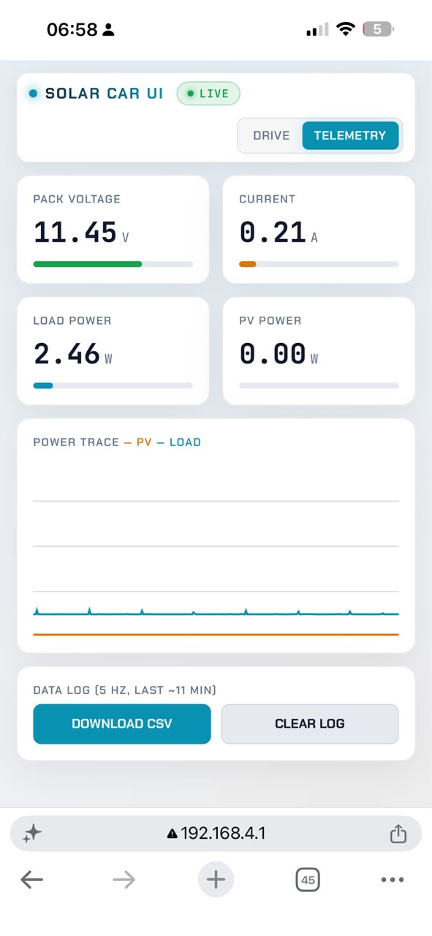
media/sys-06/sys-06_dashboard_before-usb.png
