GoldenExperienceR/EEE4022S_TRKJON002_Solar_Car/modelling and schematics/online components/enkoder30.stl

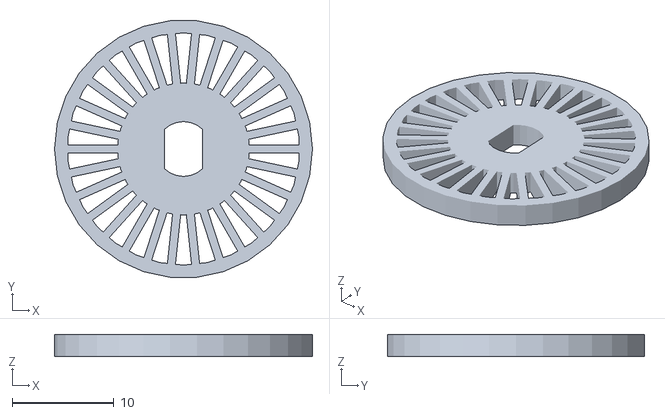
[picture p122: CAD file, 2026-10-23]
modelling and schematics/online components/enkoder30.stl
25.4 x 25.3 x 2.20
