GoldenExperienceR/EEE4022S_TRKJON002_Solar_Car/modelling and schematics/online components/Wheel D65x25.STL

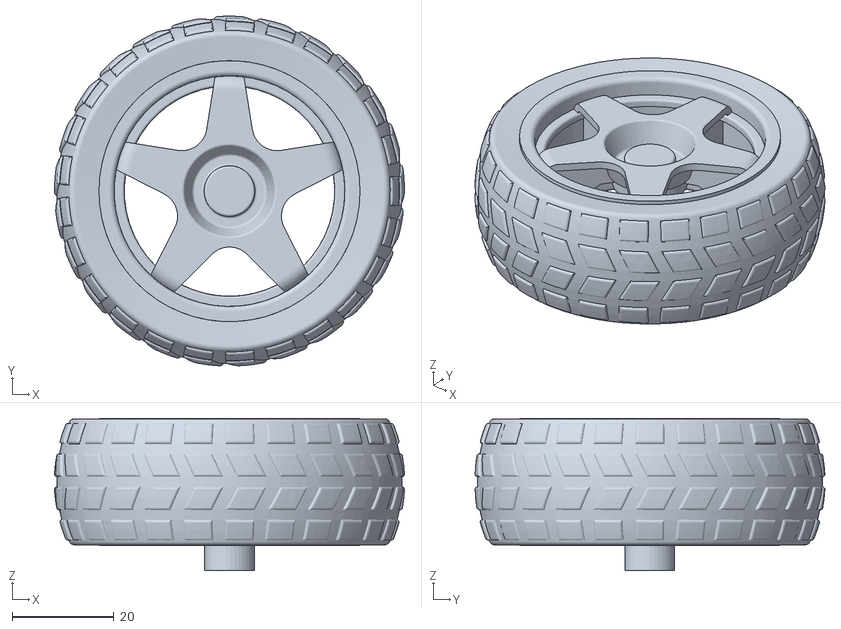
[picture p123: CAD file, 2026-10-23]
modelling and schematics/online components/Wheel D65x25.STL
68.9 x 68.9 x 30.0
