GoldenExperienceR/EEE4022S_TRKJON002_Solar_Car/figures/appx_sys14_setup.png

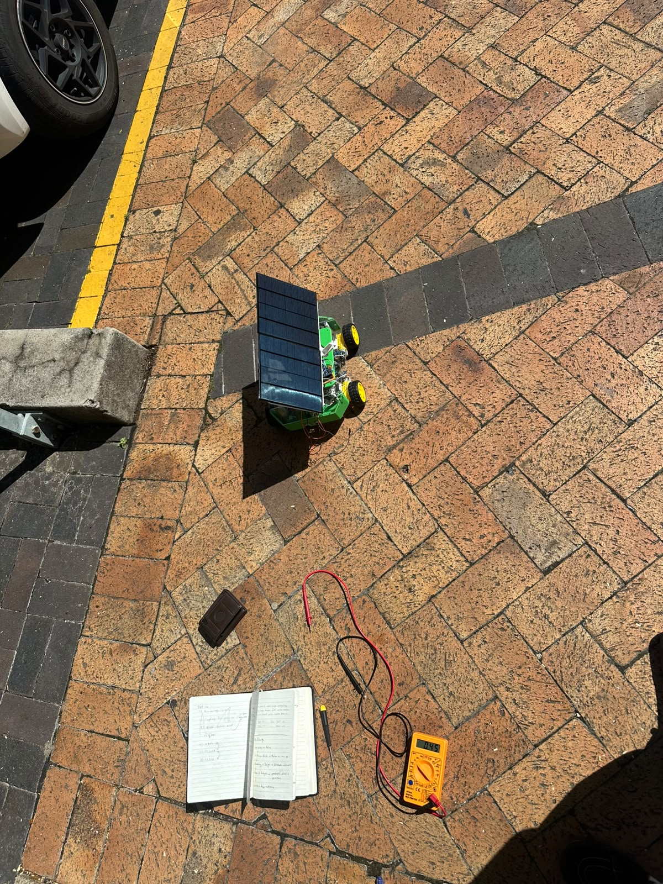
figures/appx_sys14_setup.png
