GoldenExperienceR/EEE4022S_TRKJON002_Solar_Car/figures/appx_u09_setup.png

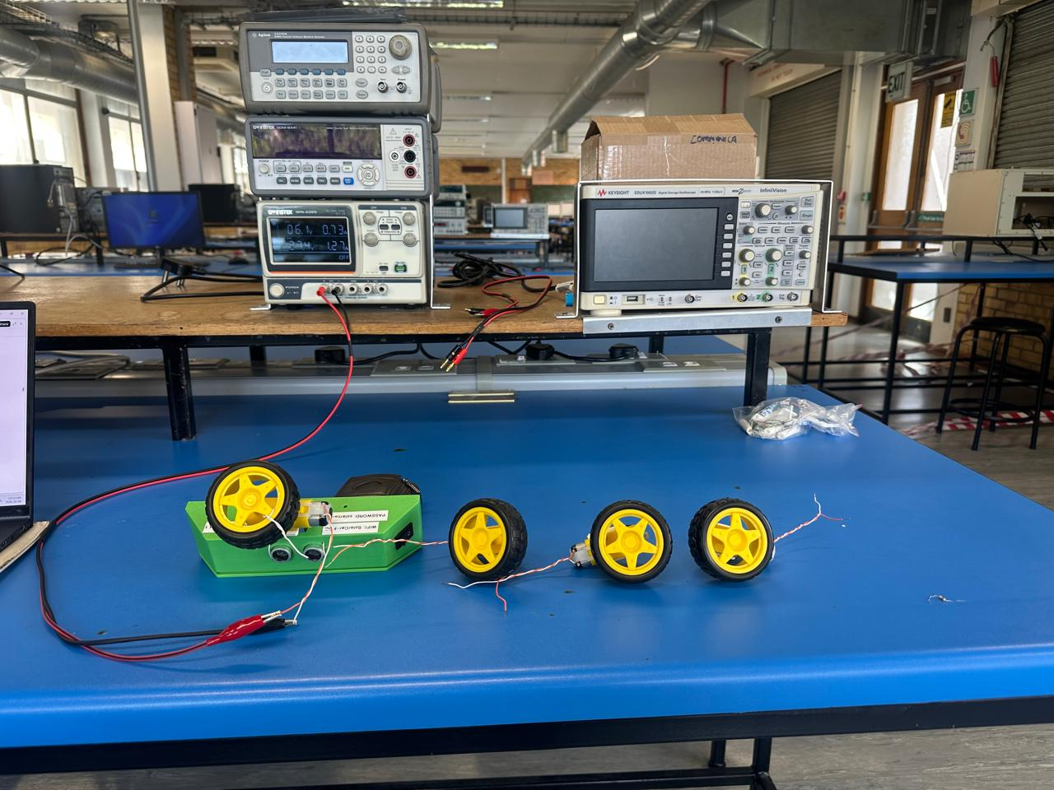
figures/appx_u09_setup.png
