GoldenExperienceR/EEE4022S_TRKJON002_Solar_Car/figures/ch2_helios_full_build.png

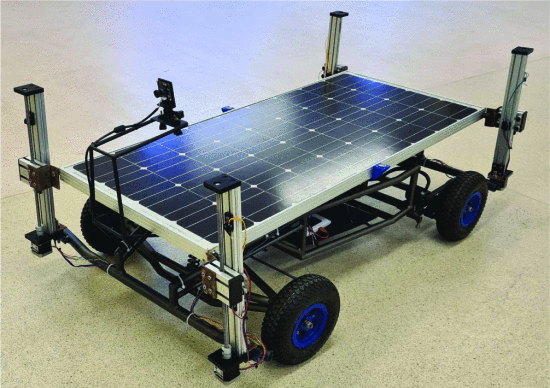
figures/ch2_helios_full_build.png
