GoldenExperienceR/EEE4022S_TRKJON002_Solar_Car/media/sys-04/sys-04_setup.jpg

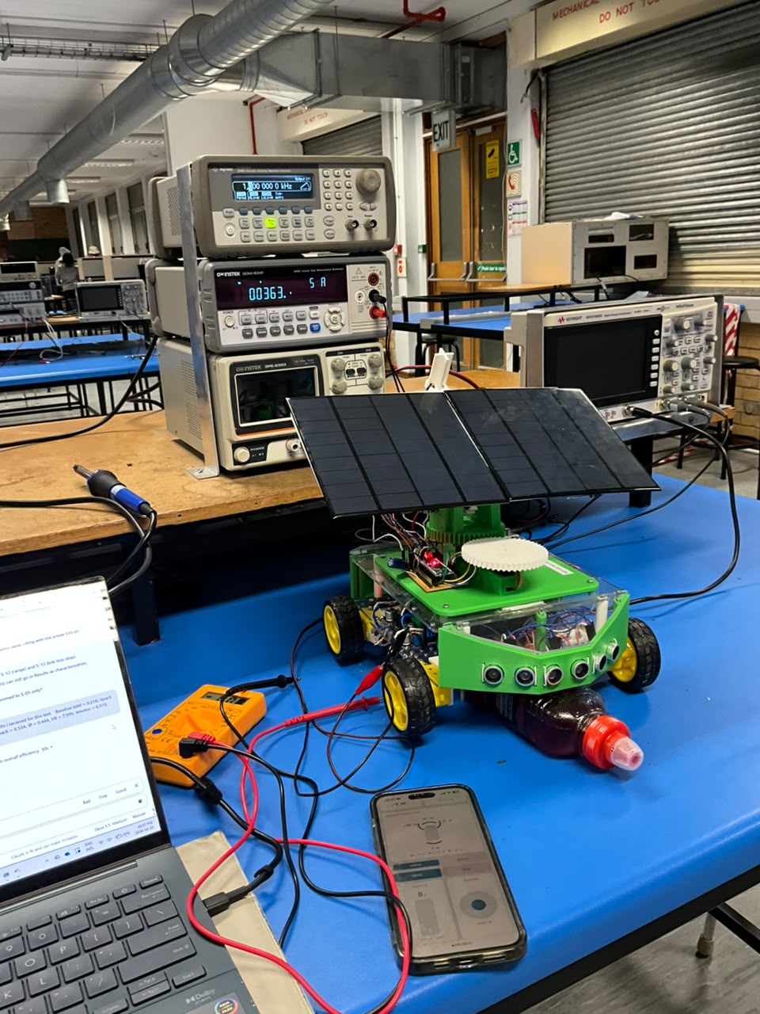
media/sys-04/sys-04_setup.jpg
