GoldenExperienceR/EEE4022S_TRKJON002_Solar_Car/media/u-16/u-16_pv-measurement-setup.png

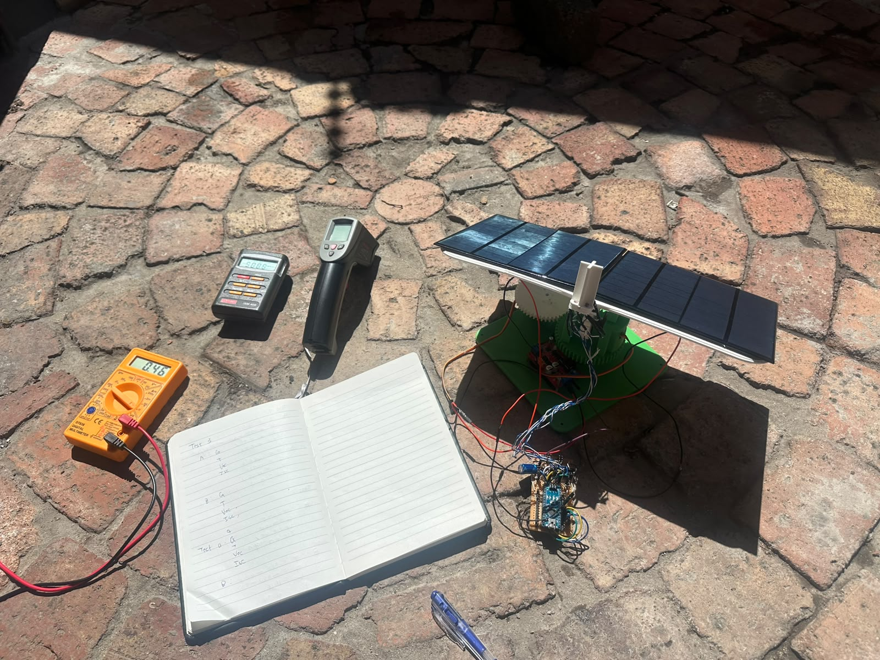
media/u-16/u-16_pv-measurement-setup.png
