GoldenExperienceR/EEE4022S_TRKJON002_Solar_Car/results/sim-01/sim01_sun_session_log.xlsx

Sheet: Log
SIM-01 sun session log (car parked, charging)
Fill the yellow cells. One row per minute for 30 min. Start the dashboard log at minute 0 and download log.csv at the end.
Date |  | 27/10/2026
Location |  | Mowbray
Start time (clock) |  | 10:30:00
Sky conditions |  | Clear
Panel orientation / tilt |  | Fixed facing sun
Tracker on or off |  | Off
MPPT set-point V_set (V) – panel voltage while charging |  | MPPT V_set = 14.8 ;
Start pack voltage, rested (V) |  | 12.18 V
End pack voltage, rested (V) |  | 12.27 V
Irradiance meter (model) |  | RS PRO ISM 400
Temperature measured on (panel surface / air) |  | Panel surface
Minute (t_min) | Clock time | Irradiance G (W/m²) | Panel temperature T (°C) | Panel voltage (V) – optional | Panel current (A) – optional | Notes (clouds, shade, tracker moved)
0 | 10:37:00 | 337.5 | 22.5 | 17.06
1 | 10:38:00 | 332.9 | 34.9 | 15
2 | 10:39:00 | 339.5 | 39 | 15.03
3 | 10:40:00 | 339.4 | 41.4 | 15.02
4 | 10:41:00 | 344.1 | 45 | 18.31
5 | 10:42:00 | 342.6 | 46.2 | 14.98
6 | 10:43:00 | 346.8 | 47.1 | 14.96
7 | 10:44:00 | 346.4 | 48.3 | 14.93
8 | 10:45:00 | 345.5 | 48.8 | 14.91
9 | 10:46:00 | 343.7 | 48.3 | 14.91
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
