GoldenExperienceR/EEE4022S_TRKJON002_Solar_Car/results/sim-01/solarcar_log_sim01.csv

t_s | pack_V | pack_A | pv_W | pv_A | panel_V | panel_A | speed_mps | soc_pct | dF_cm | dL_cm | dR_cm | dB_cm | gear | driving | failsafe | copilot_block | lv_lock | bat_ok | pv_ok | panel_ok | copilot_u
278.020 | 12.335 | -0.247 | 5.684 | 0.447 | 0.000 | 0.000 | 0.000 | 95 | 15.000 | 21.000 | 13.000 | 5.000 | 0 | 0 | 0 | 0 | 0 | 1 | 1 | 0 | 0
279.020 | 12.339 | -0.249 | 5.697 | 0.448 | 0.000 | 0.000 | 0.000 | 95 | 14.000 | 21.000 | 13.000 | 5.000 | 0 | 0 | 0 | 0 | 0 | 1 | 1 | 0 | 0
280.020 | 12.339 | -0.248 | 5.696 | 0.448 | 0.000 | 0.000 | 0.000 | 95 | 14.000 | 21.000 | 12.000 | 5.000 | 0 | 0 | 0 | 0 | 0 | 1 | 1 | 0 | 0
281.020 | 12.339 | -0.247 | 5.686 | 0.447 | 0.000 | 0.000 | 0.000 | 95 | 14.000 | 22.000 | 12.000 | 5.000 | 0 | 0 | 0 | 0 | 0 | 1 | 1 | 0 | 0
282.020 | 12.339 | -0.246 | 5.683 | 0.447 | 0.000 | 0.000 | 0.000 | 95 | 14.000 | 23.000 | 12.000 | 5.000 | 0 | 0 | 0 | 0 | 0 | 1 | 1 | 0 | 0
283.020 | 12.335 | -0.247 | 5.676 | 0.446 | 0.000 | 0.000 | 0.000 | 95 | 14.000 | 21.000 | 12.000 | 4.000 | 0 | 0 | 0 | 0 | 0 | 1 | 1 | 0 | 0
284.020 | 12.339 | -0.246 | 5.663 | 0.445 | 0.000 | 0.000 | 0.000 | 95 | 14.000 | 21.000 | 12.000 | 5.000 | 0 | 0 | 0 | 0 | 0 | 1 | 1 | 0 | 0
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
