GoldenExperienceR/EEE4022S_TRKJON002_Solar_Car/results/sys-11/Outdoor_drive_test_2026-10-23.xlsx

Sheet: Summary
Solar car outdoor drive test — 23/10/2026
Source: solarcar_log_23_10_2026.csv (car_main 5 Hz log, t = 174.8–295.3 s, 603 samples). Manual mode, Drive / STOP from rest to full throttle.
Sun runs were driven in clear sun; shade runs in shade. Condition is set by measured PV power (sun ≥ ~1.5 W, shade ≤ ~0.7 W mean).
Assumption
PV-to-battery factor (A per W of PV) |  | 0.0815 | Fitted at rest (car stopped, 325 samples): battery A = −0.0815 × PV W + 0.113, rms error 0.007 A. 0.97 W reaches the battery side per W of PV.
Idle electronics current (A) |  | 0.113 | Intercept of the same fit = draw with PV ≈ 0 (≈ 1.34 W at 11.85 V).
By condition
Metric | Sun | Shade
Runs (from rest) | 7 | 4
Mean peak speed (m/s) | 0.24 | 0.71
Best peak speed (m/s) | 0.35 | 0.73
Mean time to 90 % of peak (s) | 2.0 | 1.2
Total distance (m) | 2.8 | 10.8
Mean load power while driving (W) | 5.94 | 6.49
Mean PV power while driving (W) | 4.26 | 0.29
Mean peak battery current (A) | 0.67 | 0.96
Mean voltage sag at start (V) | 0.31 | 0.31
Total load energy (J) | 146.1620687 | 128.8725815
Total battery energy (J) | 30.73087304 | 123.2554085
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
