GoldenExperienceR/EEE4022S_TRKJON002_Solar_Car/results/sys-11/solarcar_log_23_10_2026.csv

t_s | pack_V | pack_A | pv_W | speed_mps | soc_pct | dF_cm | dL_cm | dR_cm | dB_cm | gear | driving | failsafe | copilot_block | lv_lock | bat_ok | pv_ok | copilot_u
174.84 | 11.977 | -0.345 | 5.611 | 0.000 | 76 | 400 | 124 | 400 |  | 1 | 0 | 0 | 0 | 0 | 1 | 1 | 0
175.03 | 11.977 | -0.345 | 5.605 | 0.000 | 76 | 400 | 124 | 400 |  | 1 | 0 | 0 | 0 | 0 | 1 | 1 | 0
175.24 | 11.973 | -0.345 | 5.612 | 0.000 | 76 | 400 | 125 | 400 |  | 1 | 0 | 0 | 0 | 0 | 1 | 1 | 0
175.44 | 11.977 | -0.346 | 5.629 | 0.000 | 76 | 400 | 124 | 400 |  | 1 | 0 | 0 | 0 | 0 | 1 | 1 | 0
175.63 | 11.977 | -0.348 | 5.635 | 0.000 | 76 | 400 | 126 | 400 |  | 1 | 0 | 0 | 0 | 0 | 1 | 1 | 0
175.84 | 11.980 | -0.347 | 5.641 | 0.000 | 76 | 72 | 29 | 400 |  | 1 | 0 | 0 | 0 | 0 | 1 | 1 | 0
176.03 | 11.976 | -0.313 | 5.647 | 0.000 | 76 | 400 | 126 | 400 |  | 1 | 0 | 0 | 0 | 0 | 1 | 1 | 0
176.24 | 11.980 | -0.350 | 5.681 | 0.000 | 76 | 73 | 29 | 400 |  | 1 | 0 | 0 | 0 | 0 | 1 | 1 | 0
176.44 | 11.980 | -0.353 | 5.694 | 0.000 | 76 | 72 | 30 | 400 |  | 1 | 0 | 0 | 0 | 0 | 1 | 1 | 0
176.63 | 11.980 | -0.352 | 5.713 | 0.000 | 76 | 400 | 126 | 400 |  | 1 | 0 | 0 | 0 | 0 | 1 | 1 | 0
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
