GoldenExperienceR/EEE4022S_TRKJON002_Solar_Car/figures/ch2_helios_tracking_test.png

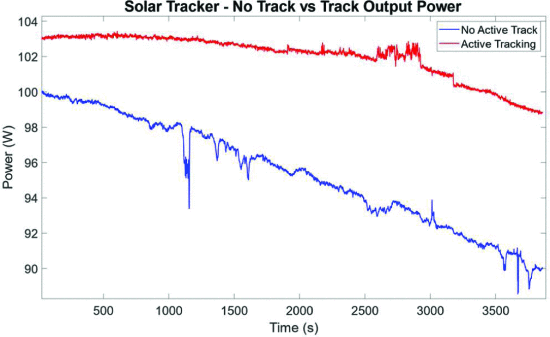
figures/ch2_helios_tracking_test.png
