GoldenExperienceR/EEE4022S_TRKJON002_Solar_Car/testing code/02_dashboard_ui/preview.png

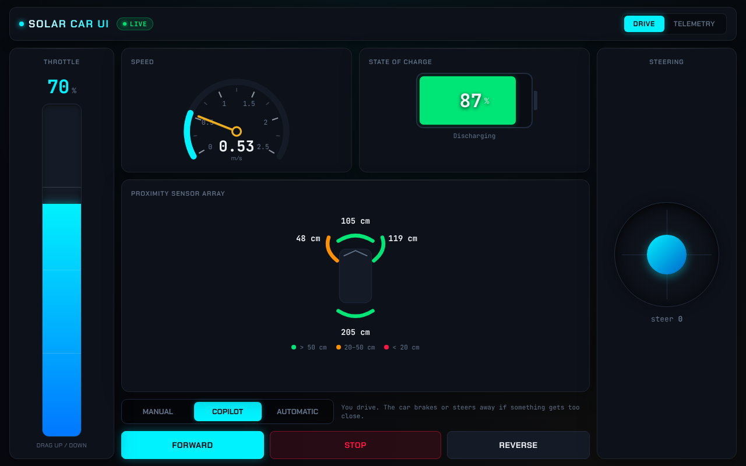
testing code/02_dashboard_ui/preview.png
