GoldenExperienceR/EEE4022S_TRKJON002_Solar_Car/figures/ch3_copilot_controller.pdf

Limit 0–100 %
(excess moved to

Hysteresis
stop: dF < 25 cm
release: dF > 30 cm
