GoldenExperienceR/EEE4022S_TRKJON002_Solar_Car/figures/ch3_control_schematic.pdf

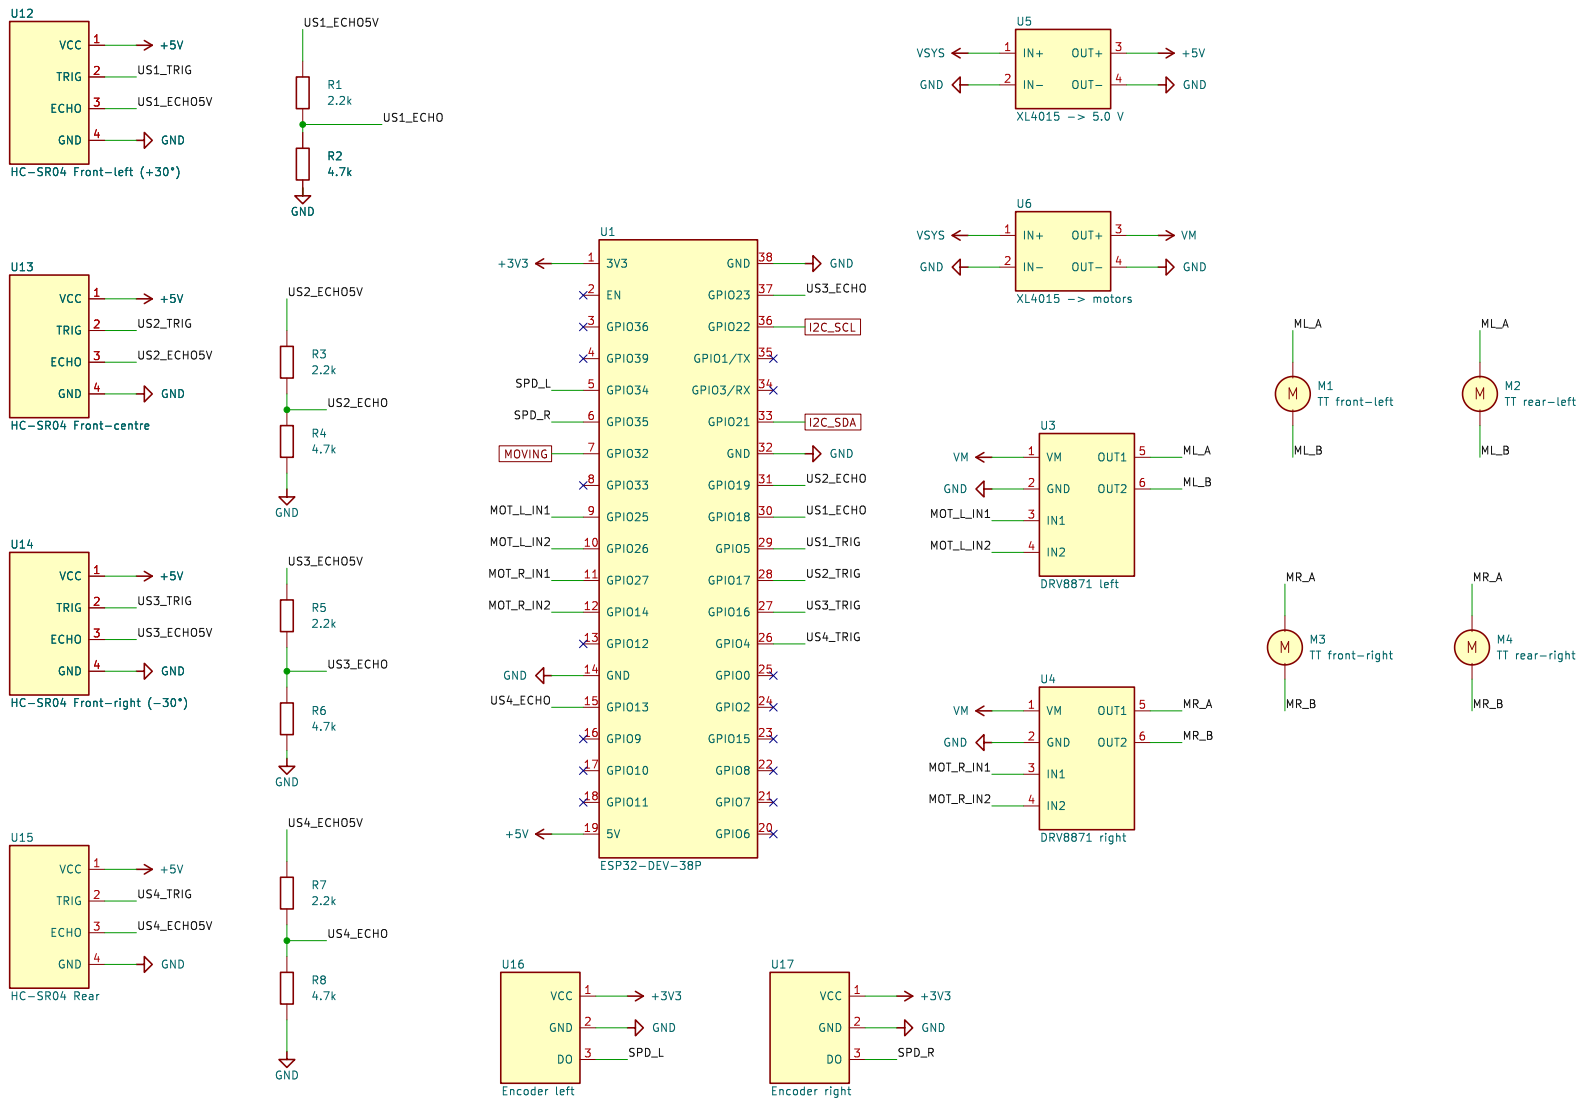
[picture p131: page 1]
