GoldenExperienceR/EEE4022S_TRKJON002_Solar_Car/figures/ch3_power_schematic.pdf

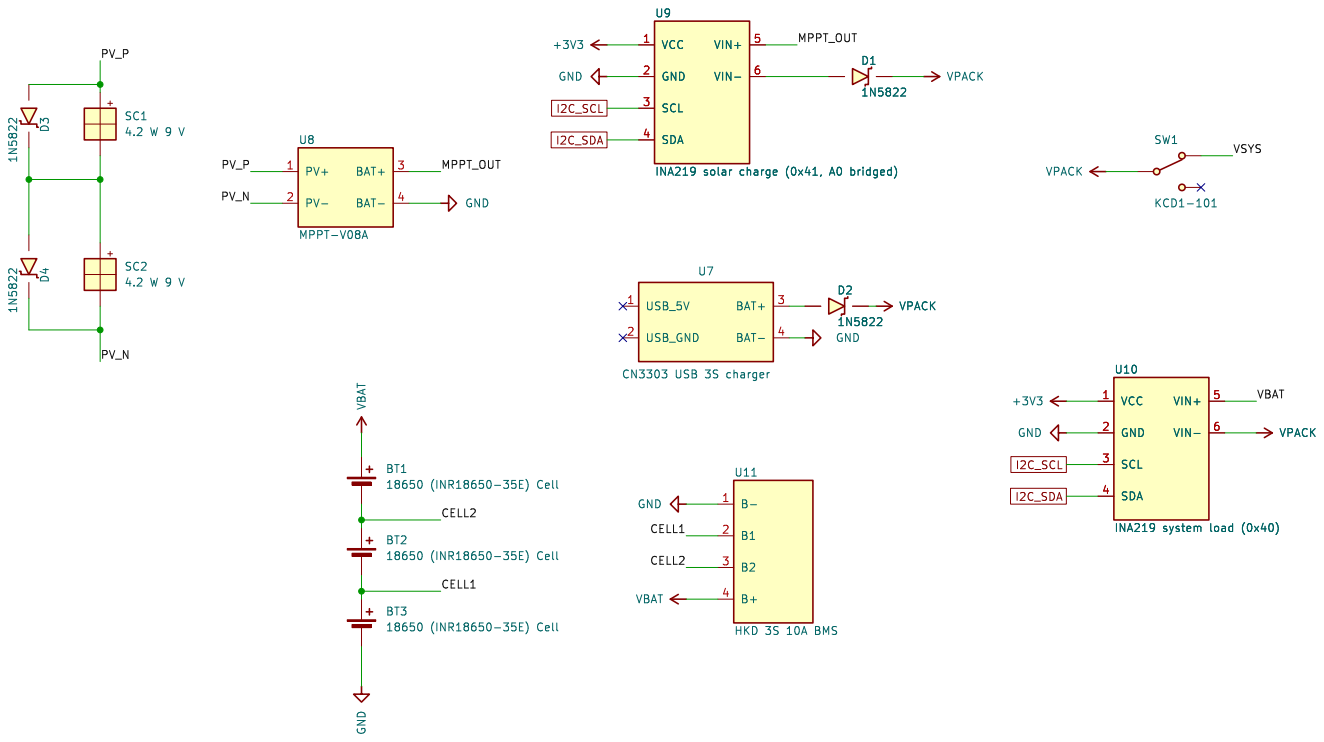
[picture p132: page 1]
