GoldenExperienceR/EEE4022S_TRKJON002_Solar_Car/figures/ch3_tracker_schematic.pdf

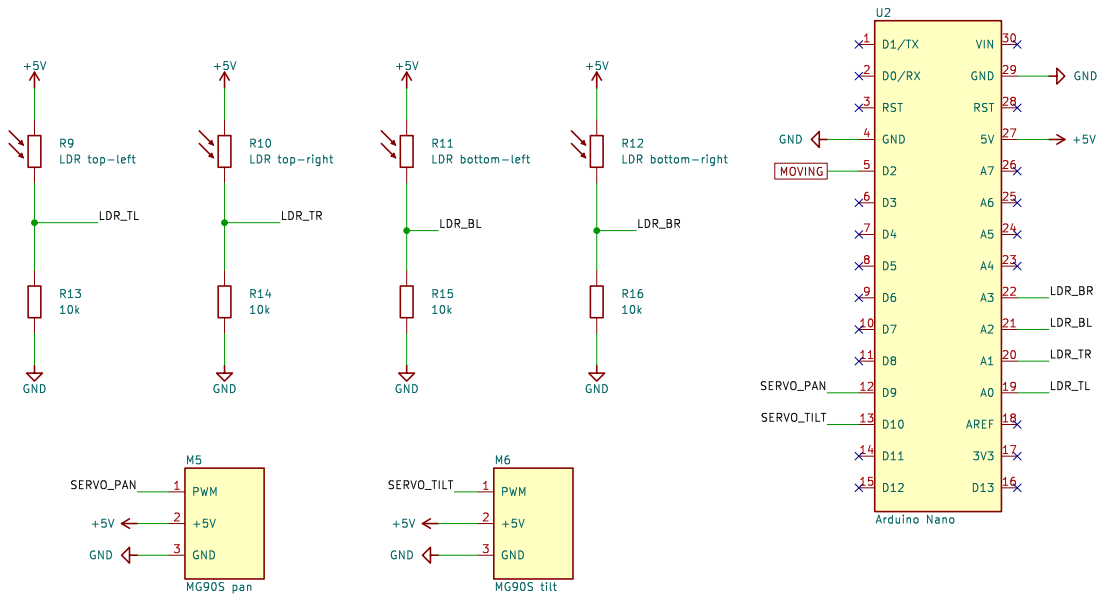
[picture p133: page 1]
